anabrid/Model-1/software/examples/mathieu/README.md

mathieu.pl and its associated mathieu.yml perform a parameter variation in 
Mathieu's differential equation. For each parameter the y output is sampled
and finally displayed.
