anabrid/Model-1/(threads)

Thread 1 (2024-01-17):

MLT8 schematics are missing

metebalci, 2024-01-17:
MLT8 folder contains the schematics of MDS2.
