anabrid/Model-1/hardware/backplanes_etc/Backplane - Schematic.pdf

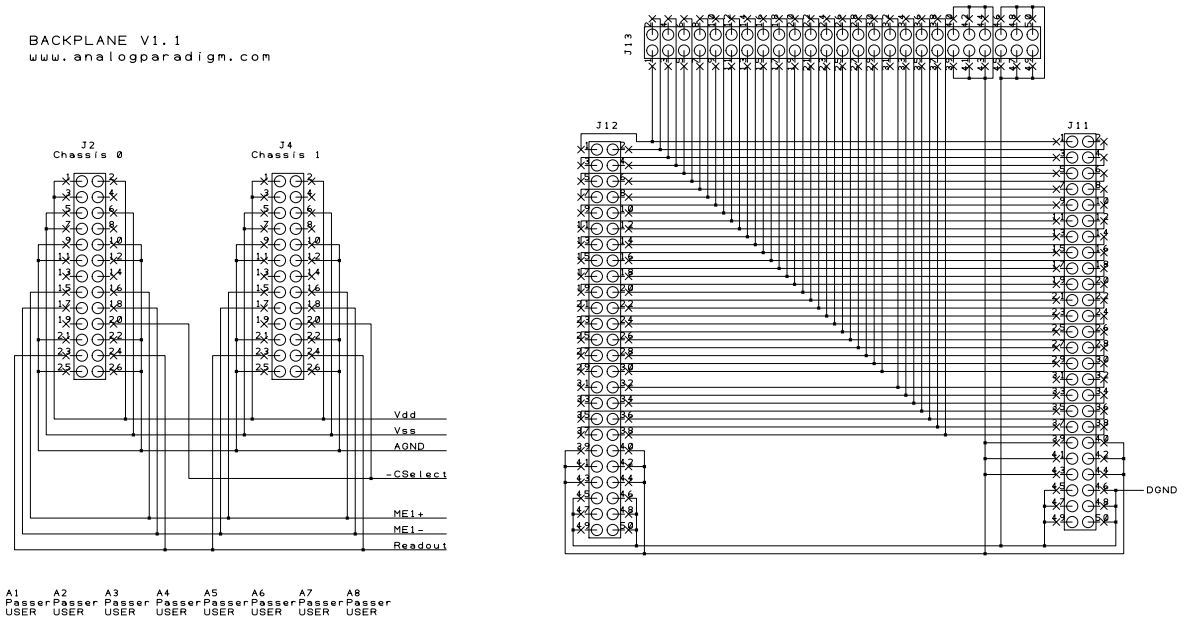
[picture p1: page 1]
