anabrid/Model-1/hardware/backplanes_etc/BackplaneMains - Schematic.pdf

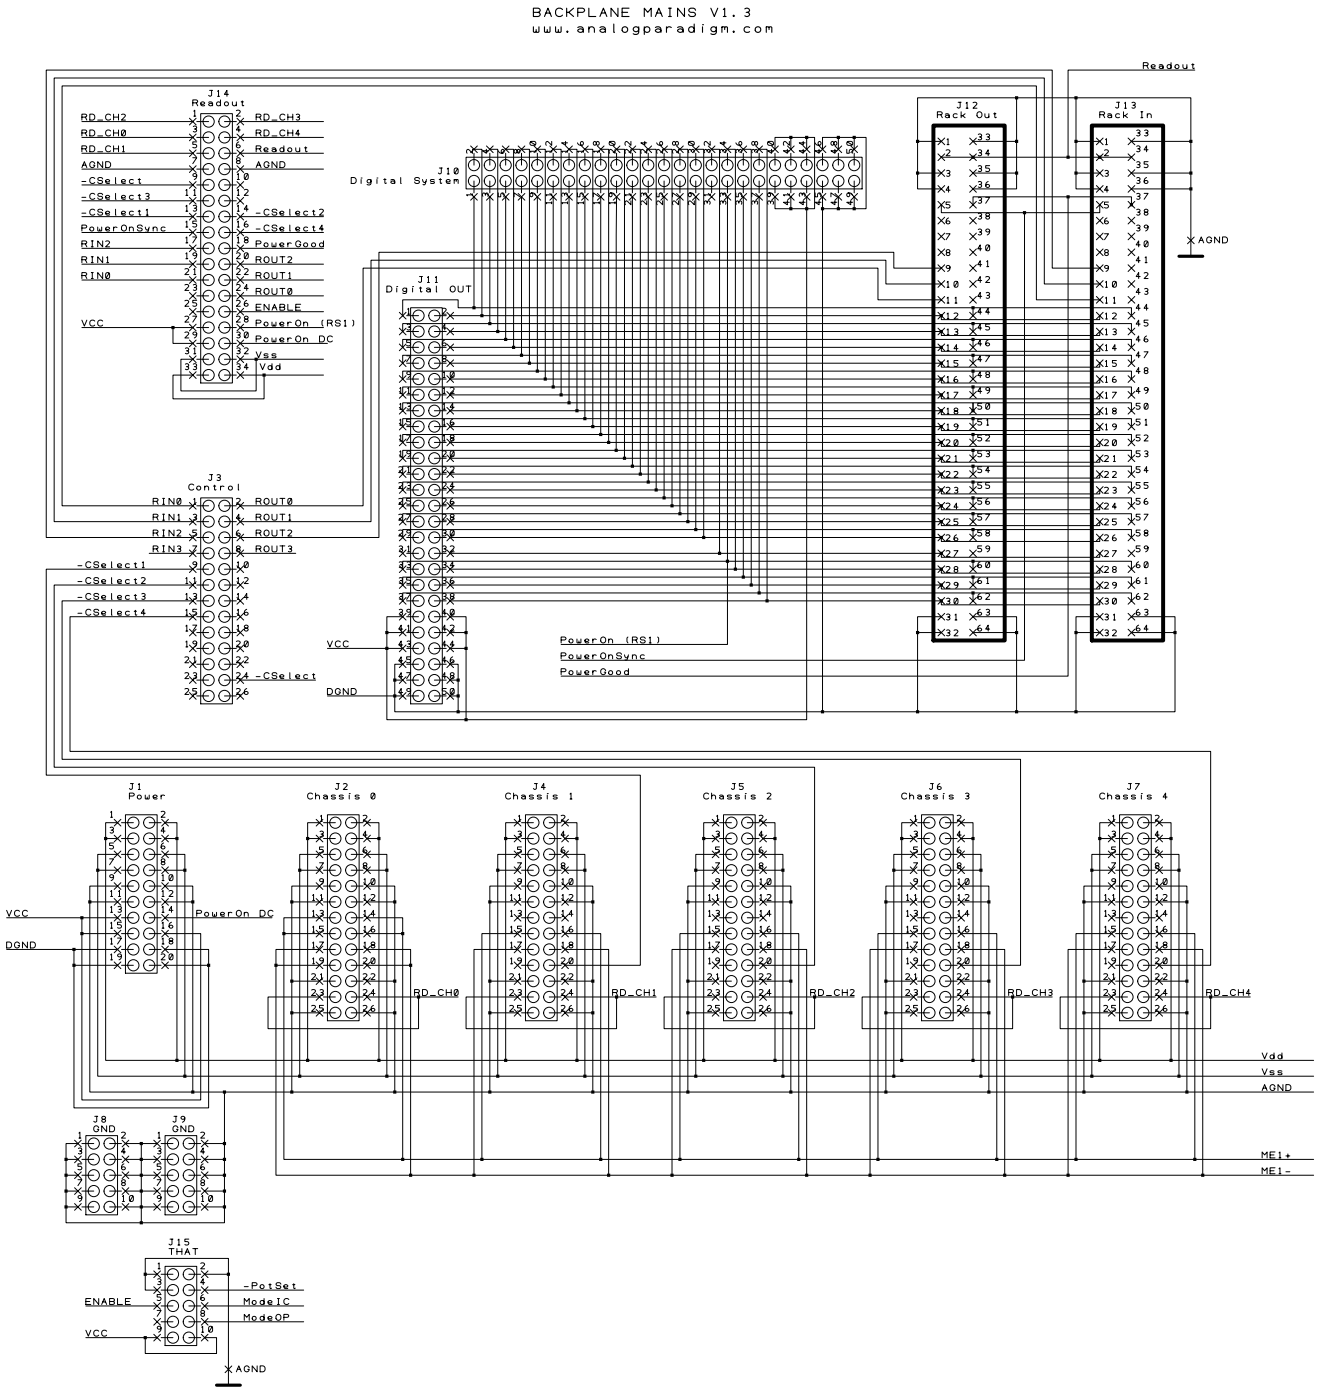
[picture p2: page 1]
