anabrid/Model-1/hardware/backplanes_etc/DCDC-Mains - Schematic.pdf

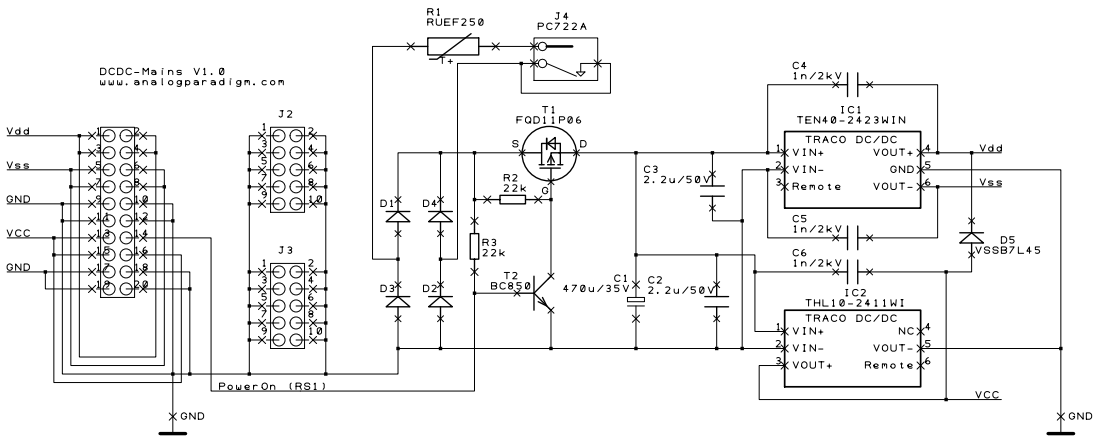
[picture p3: page 1]
