anabrid/Model-1/hardware/backplanes_etc/Readout-Mains - Schematic.pdf

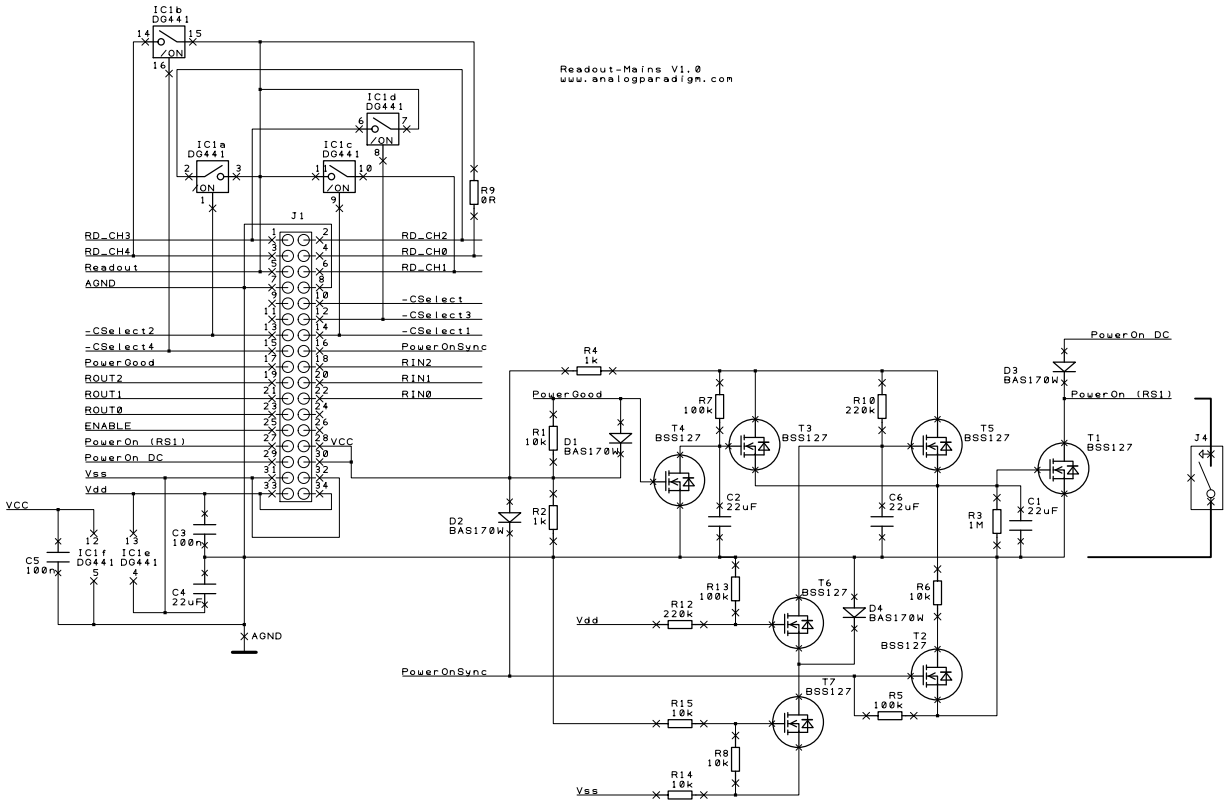
[picture p4: page 1]
