anabrid/Model-1/hardware/backplanes_etc/SYSBUS - Schematic.pdf

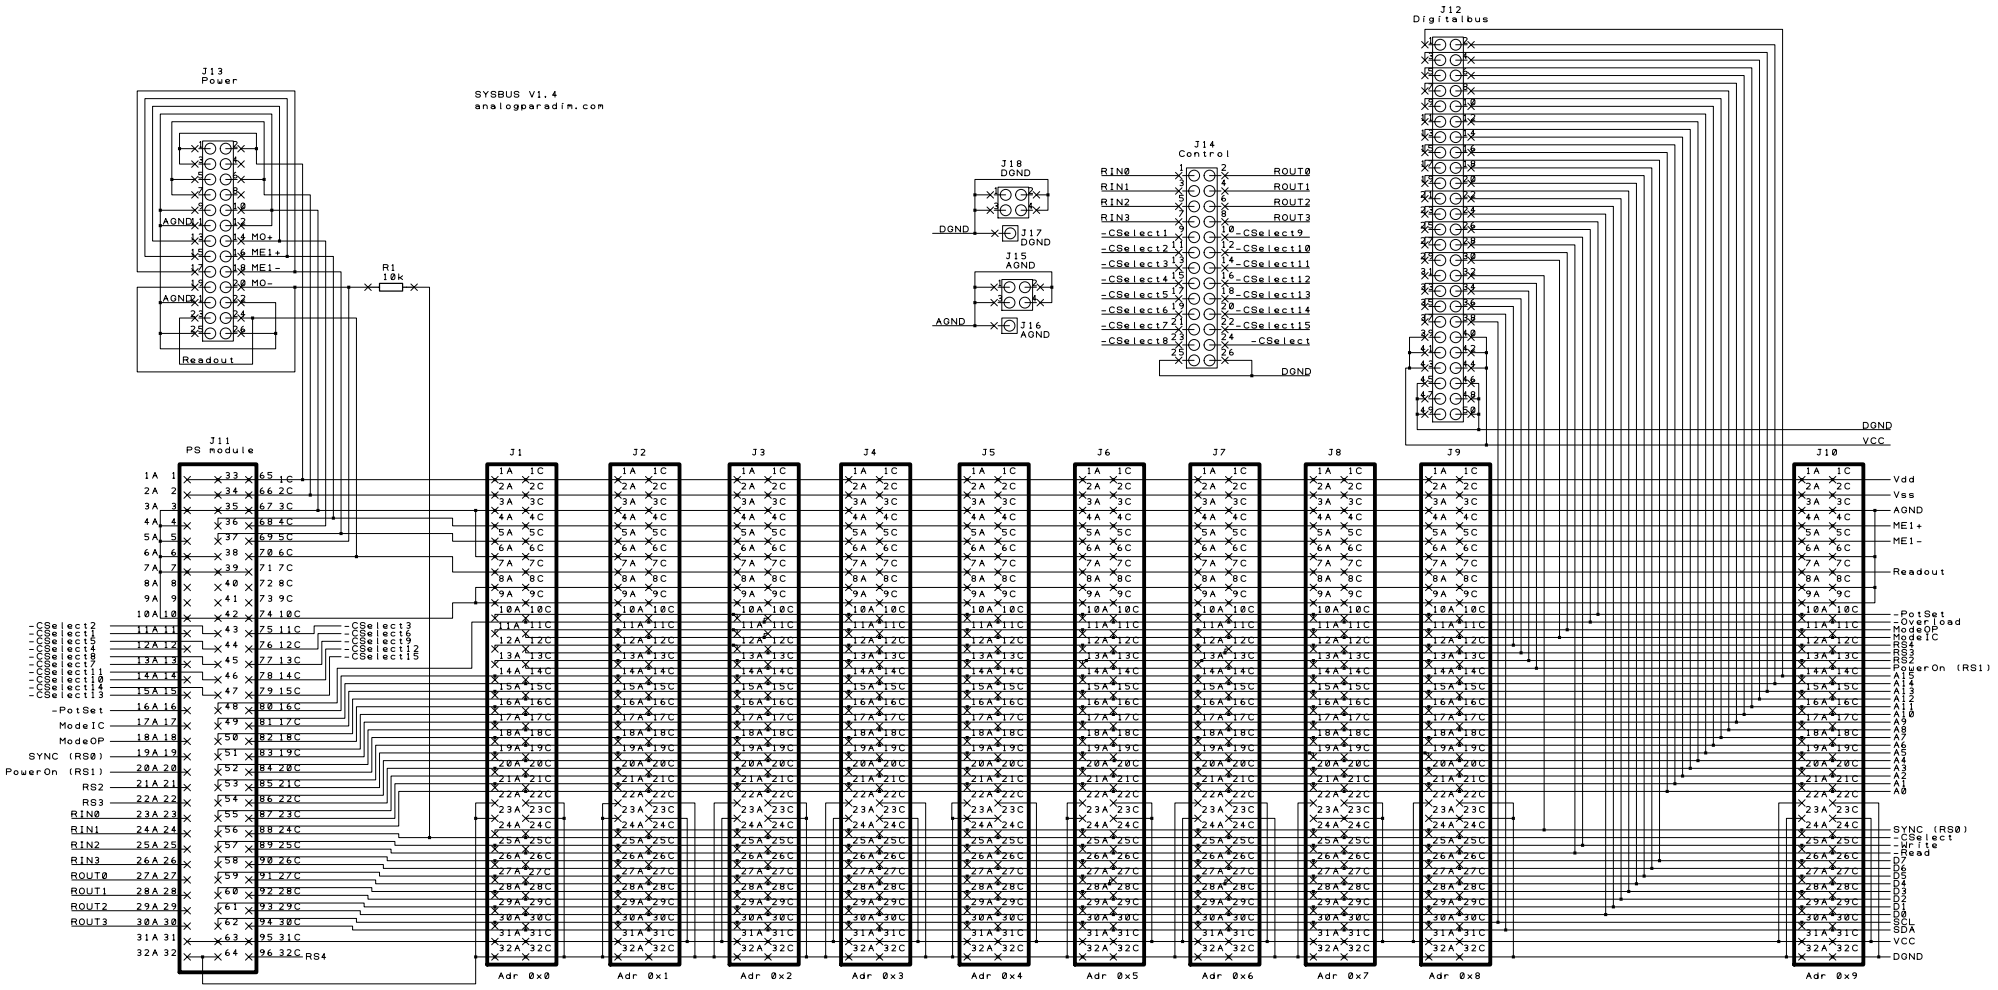
[picture p5: page 1]
