anabrid/Model-1/hardware/backplanes_etc/SYSBUS_Term - Schematic.pdf

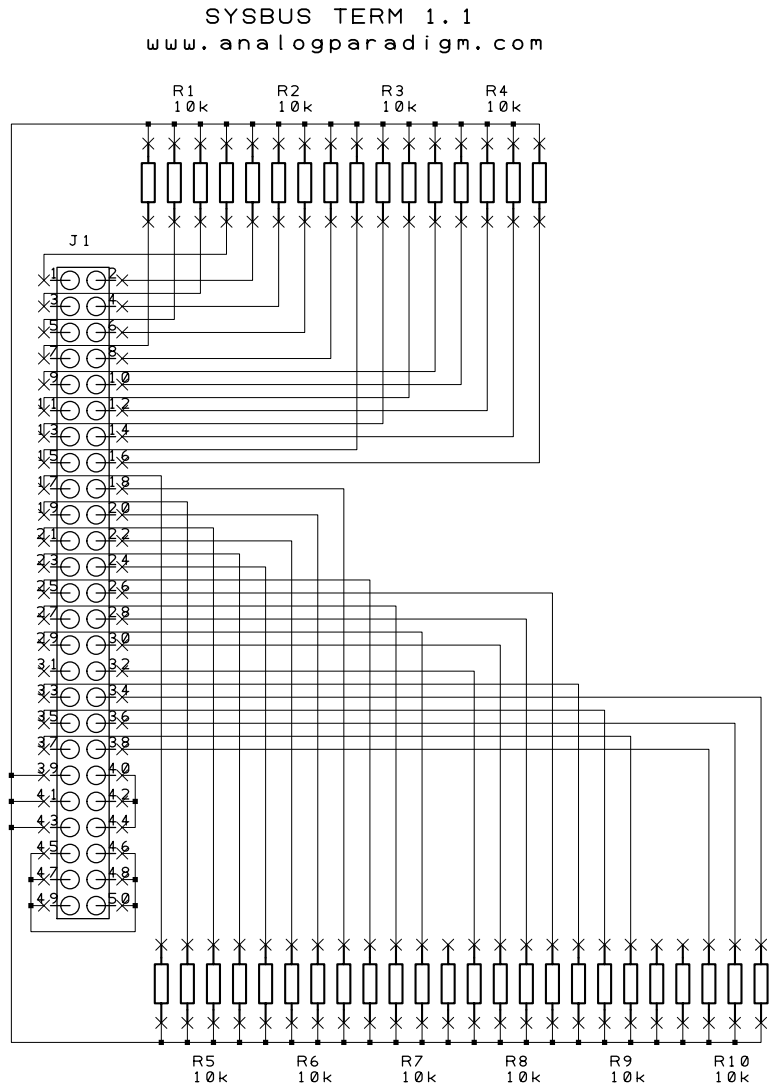
[picture p6: page 1]
