anabrid/Model-1/hardware/CMP4/CMP4 - Schematic.pdf

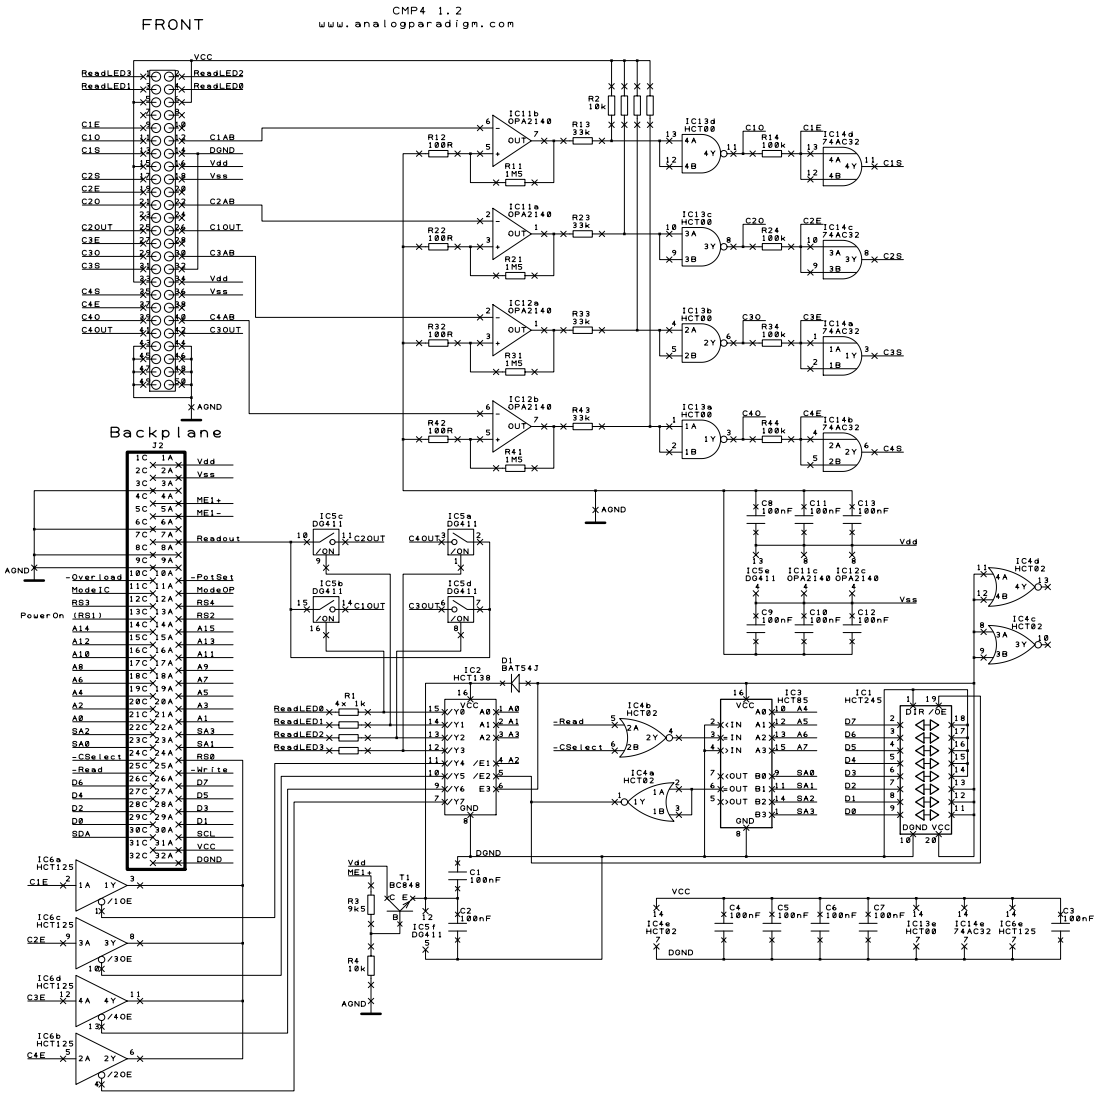
[picture p7: page 1]
