anabrid/Model-1/hardware/CMP4/CMP4-Front - Schematic.pdf

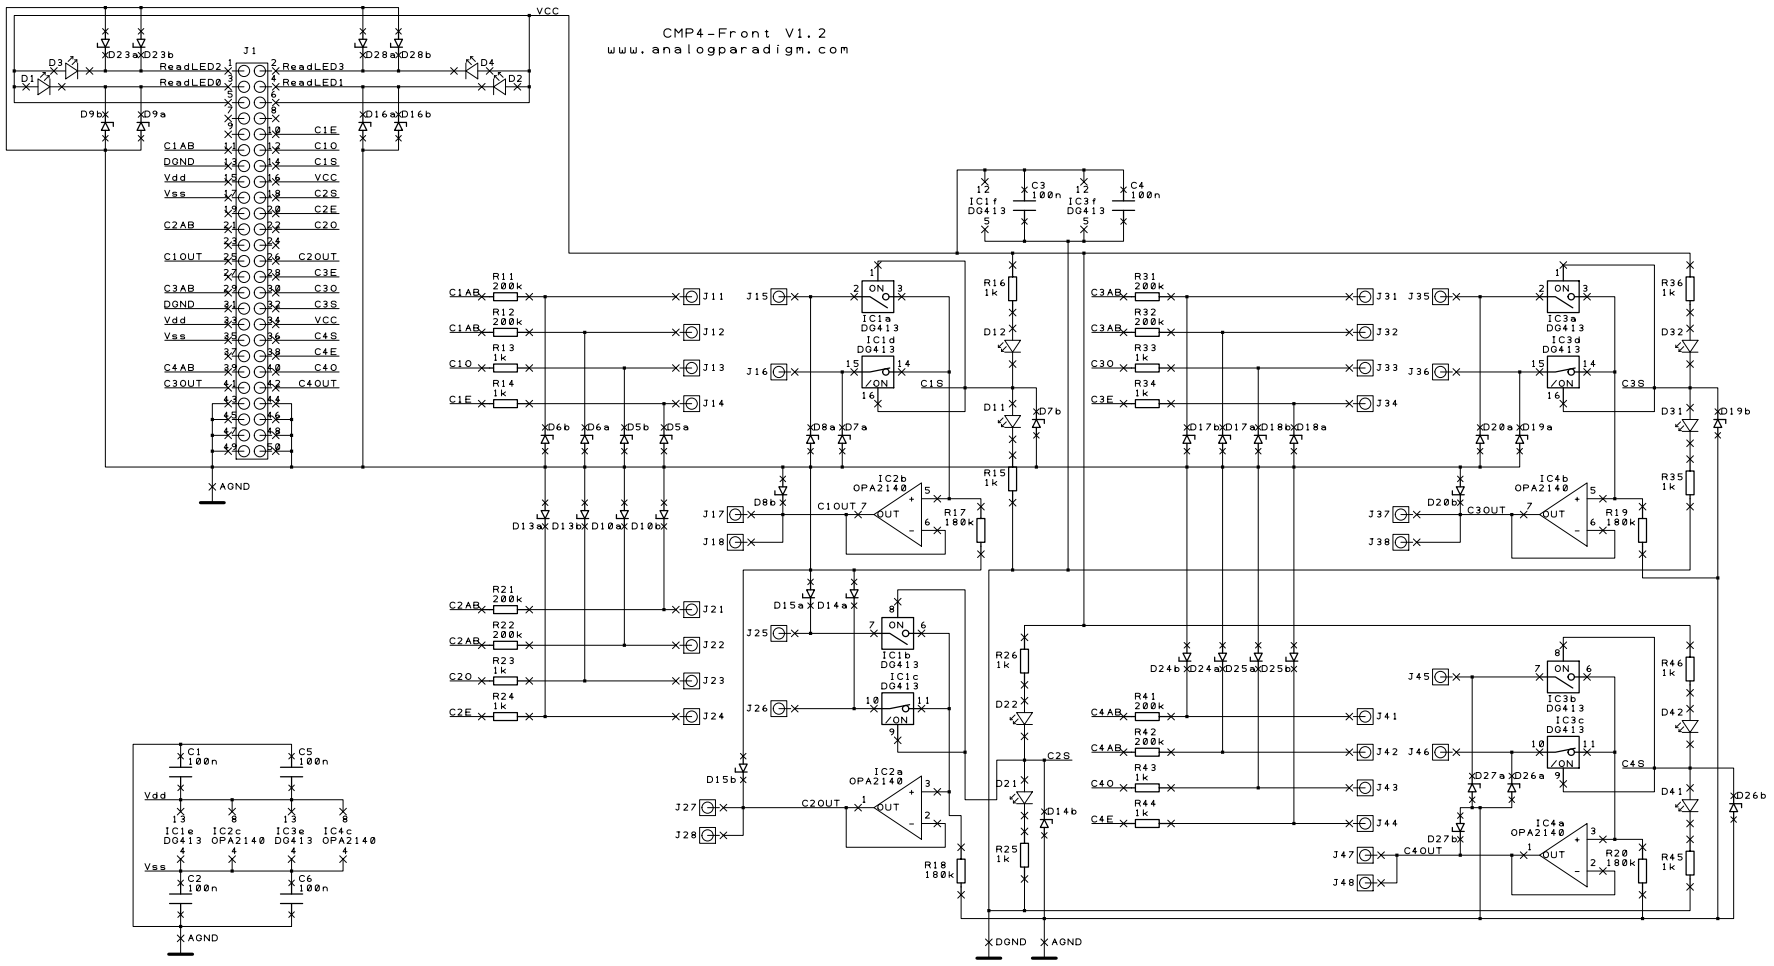
[picture p8: page 1]
