anabrid/Model-1/hardware/CU/CU - Schematic.pdf

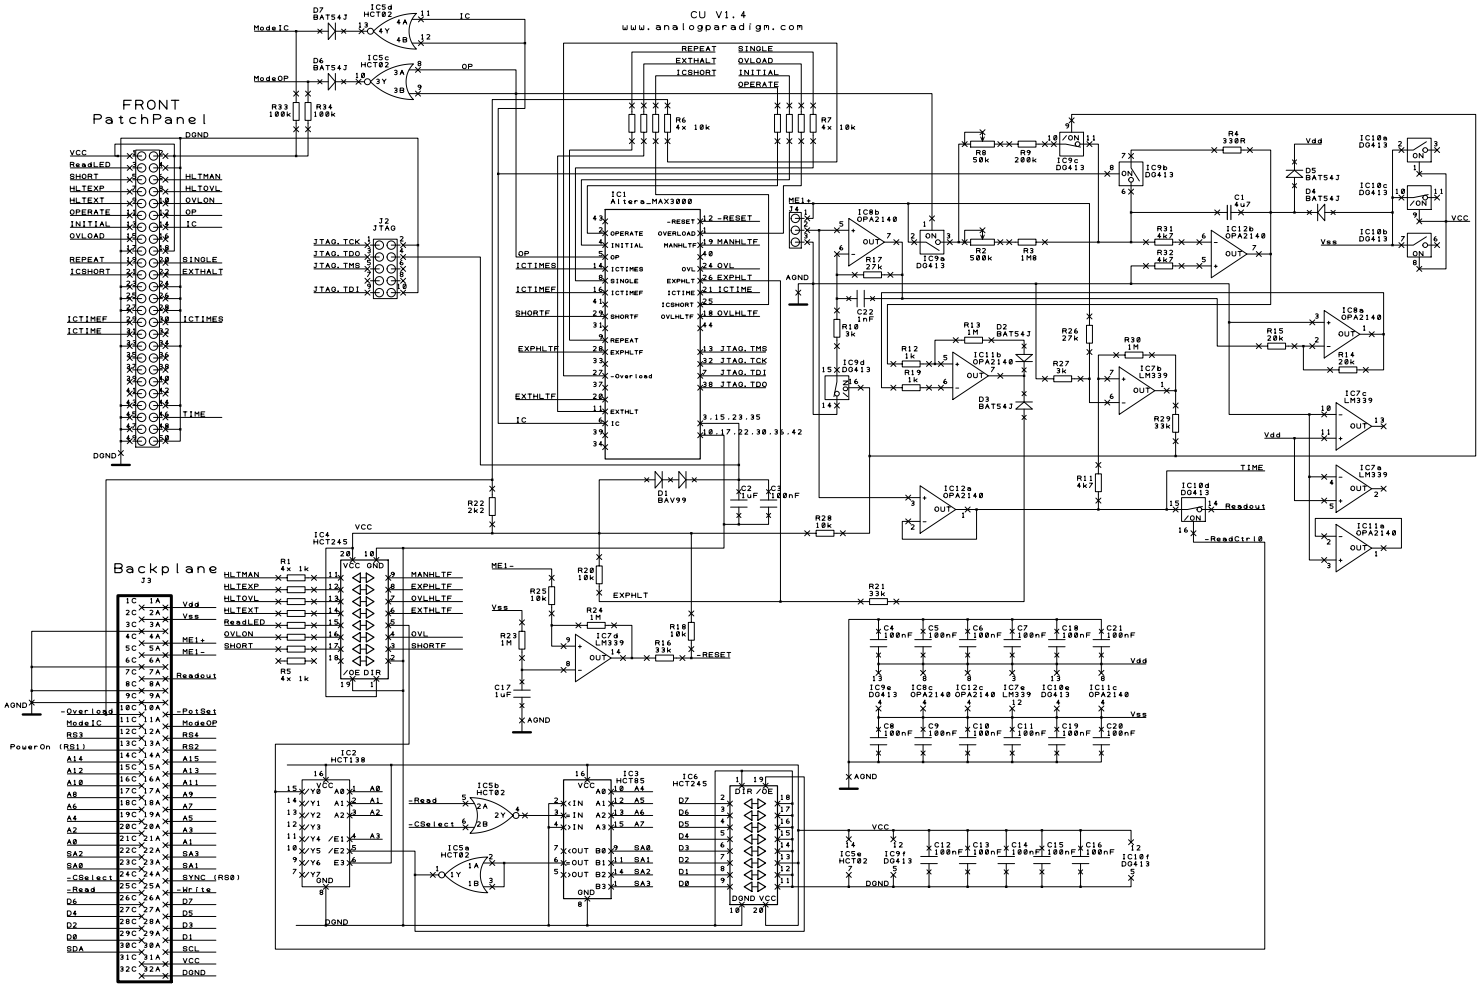
[picture p9: page 1]
