anabrid/Model-1/hardware/CU/CU-Front - Schematic.pdf

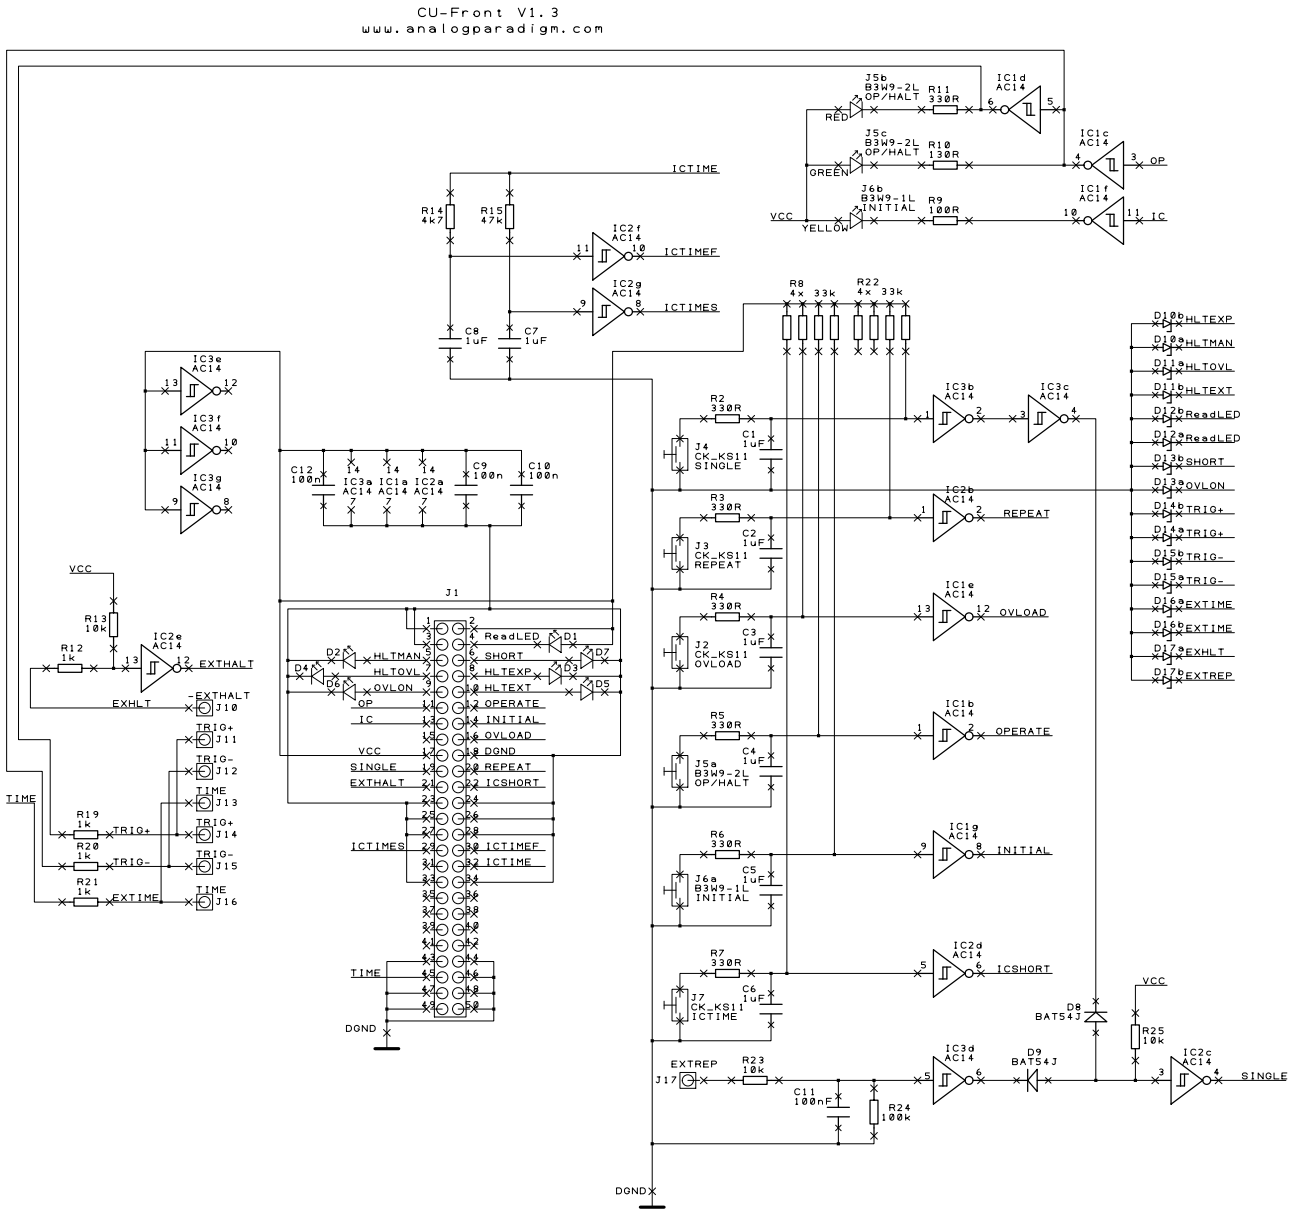
[picture p10: page 1]
