anabrid/Model-1/hardware/DPT24/DPT24 - Schematic.pdf

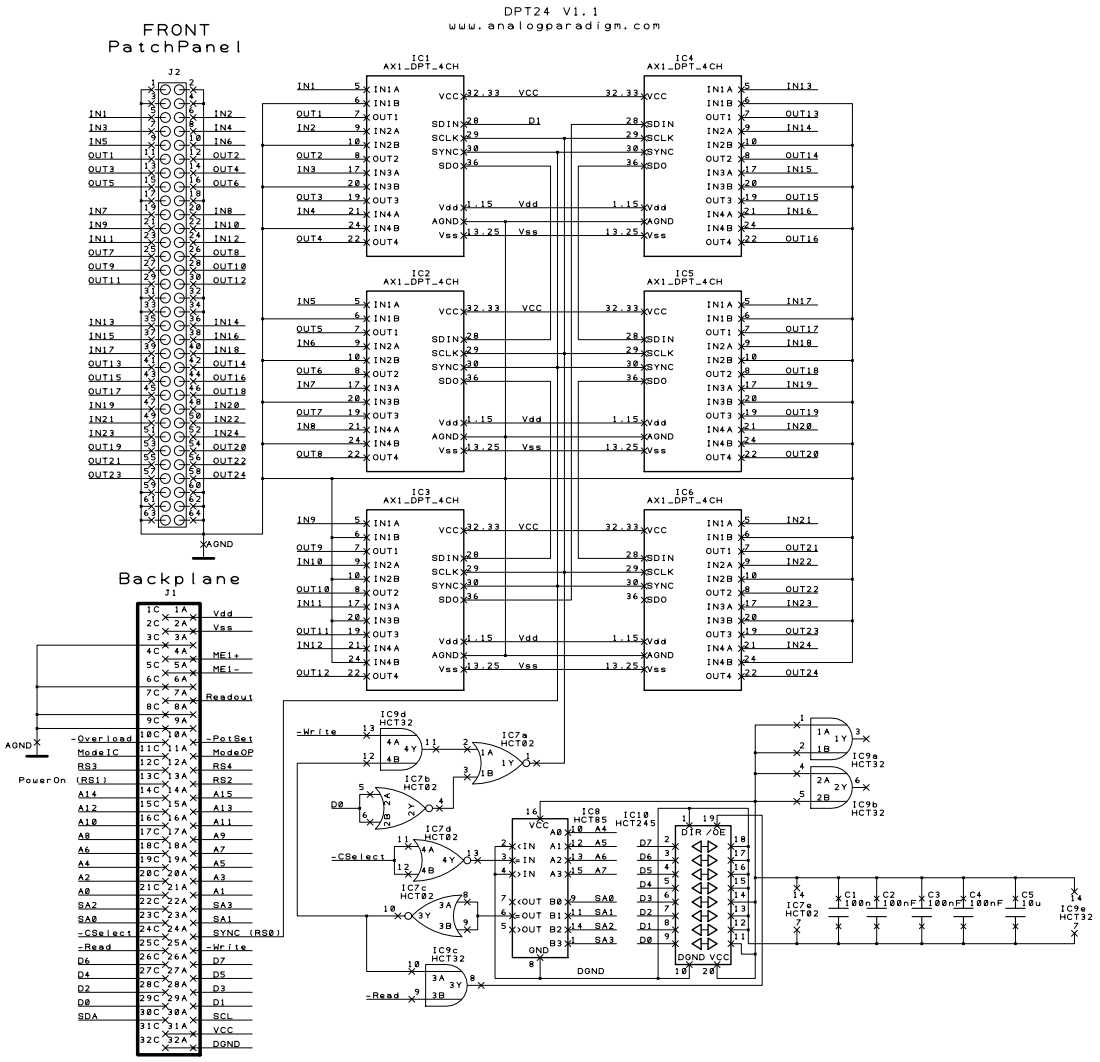
[picture p11: page 1]
