anabrid/Model-1/hardware/DPT24/DPT24-FRONT - Schematic.pdf

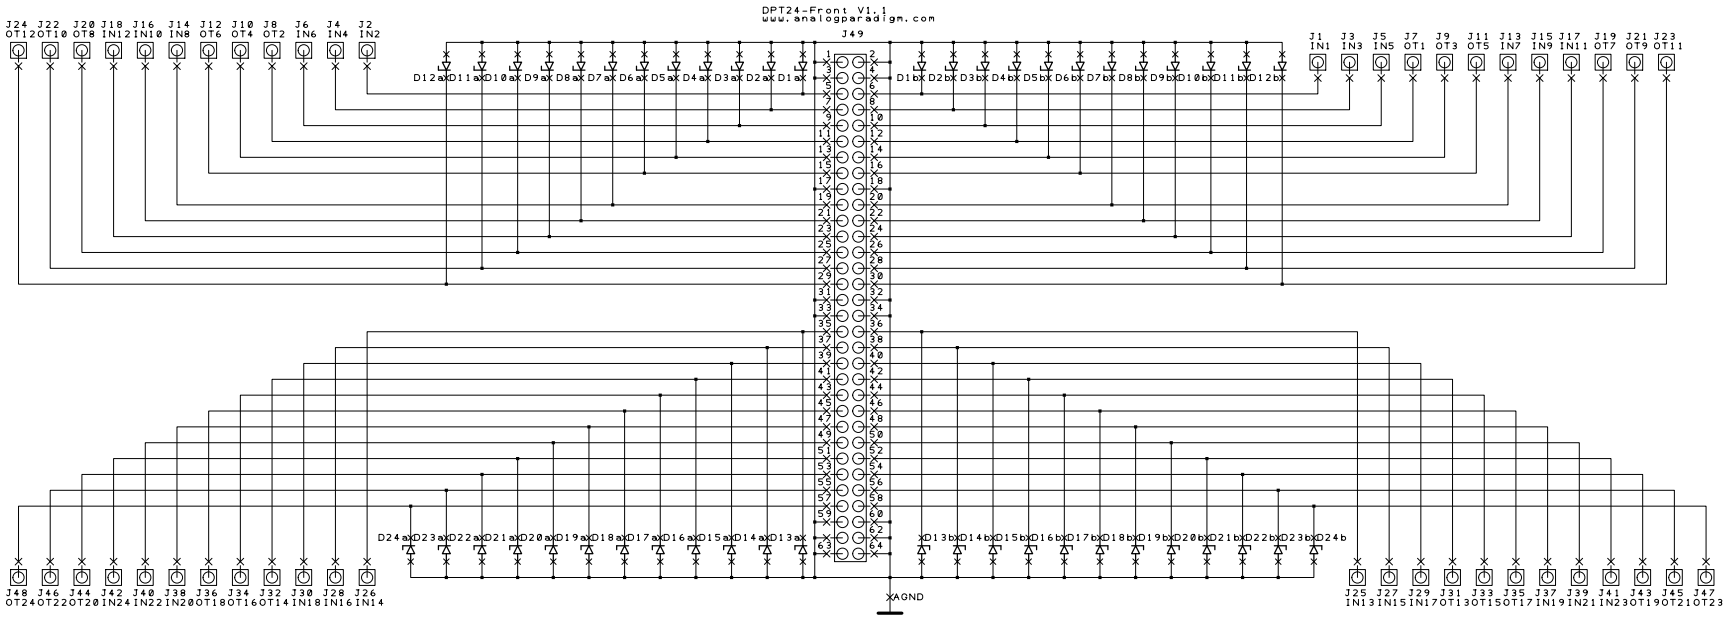
[picture p12: page 1]
