anabrid/Model-1/hardware/DPT24/DPT_4Ch - Schematic.pdf

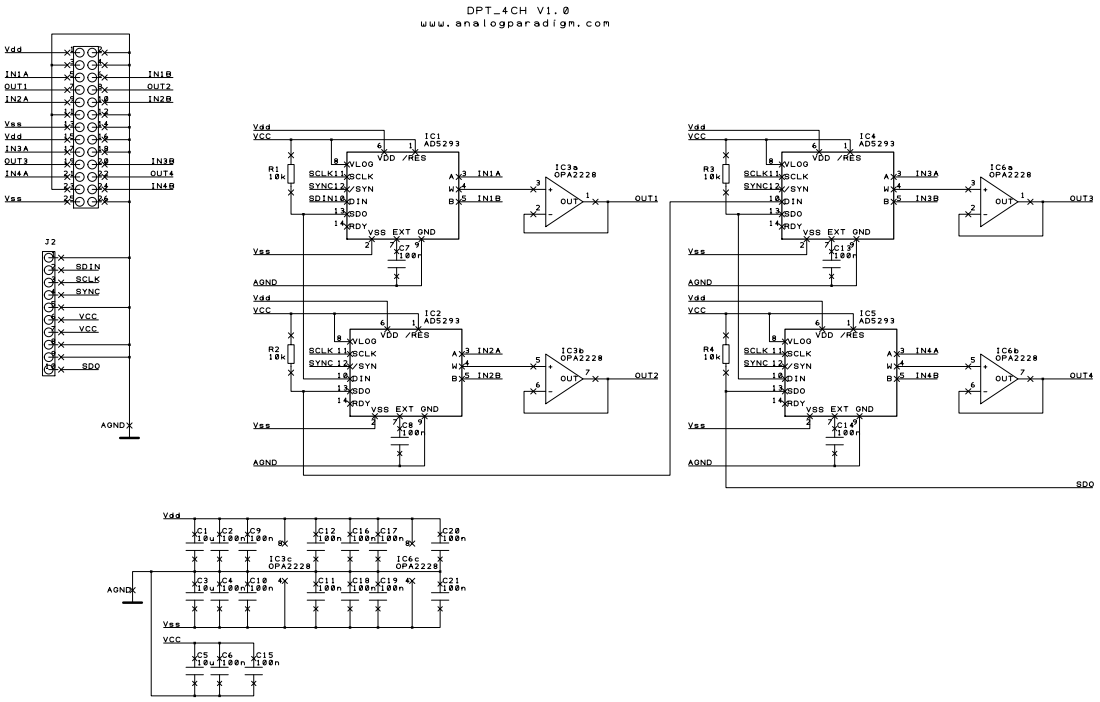
[picture p13: page 1]
