anabrid/Model-1/hardware/HC/HC - Schematic.pdf

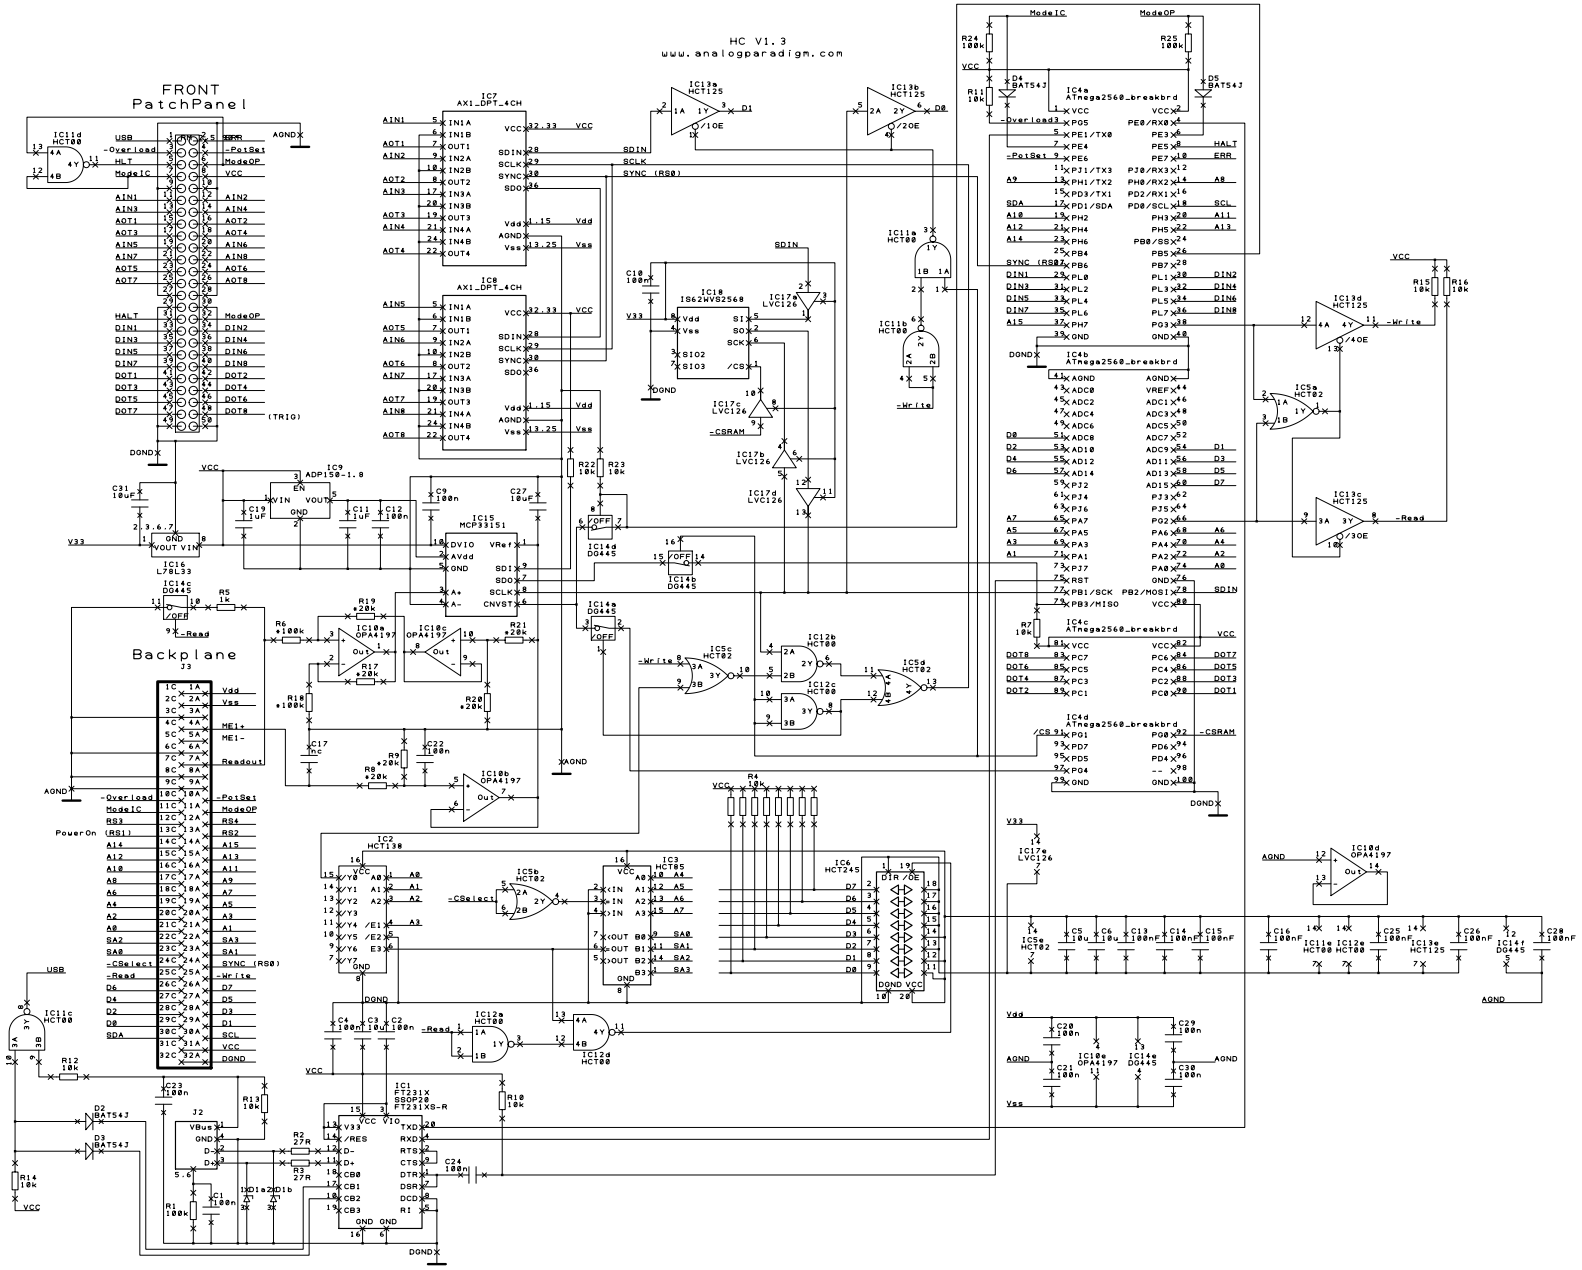
[picture p14: page 1]
