anabrid/Model-1/hardware/HC/HC-Front - Schematic.pdf

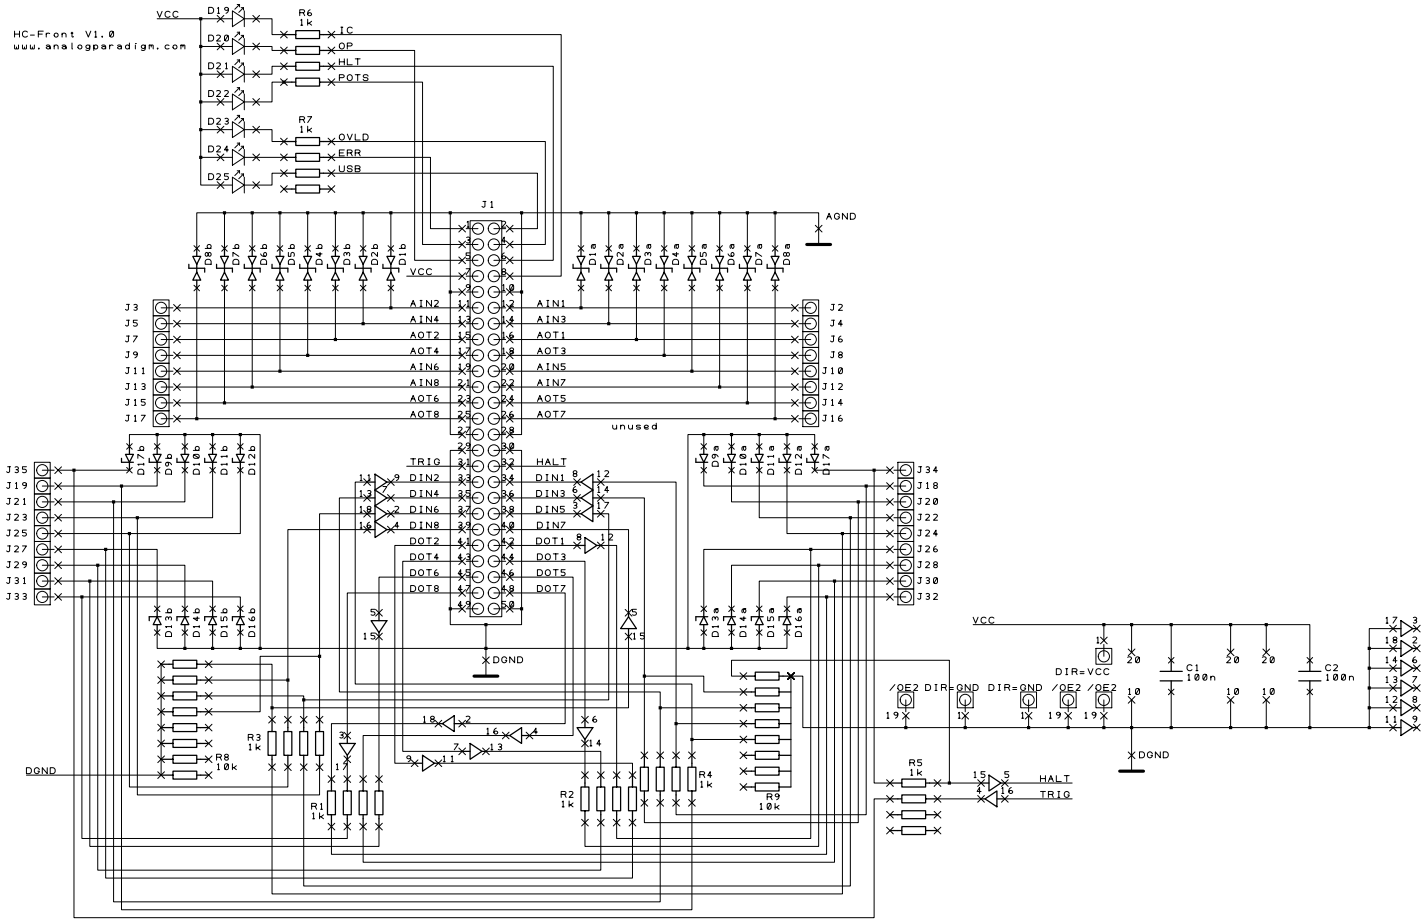
[picture p15: page 1]
