anabrid/Model-1/hardware/INT4/INT4 - Schematic.pdf

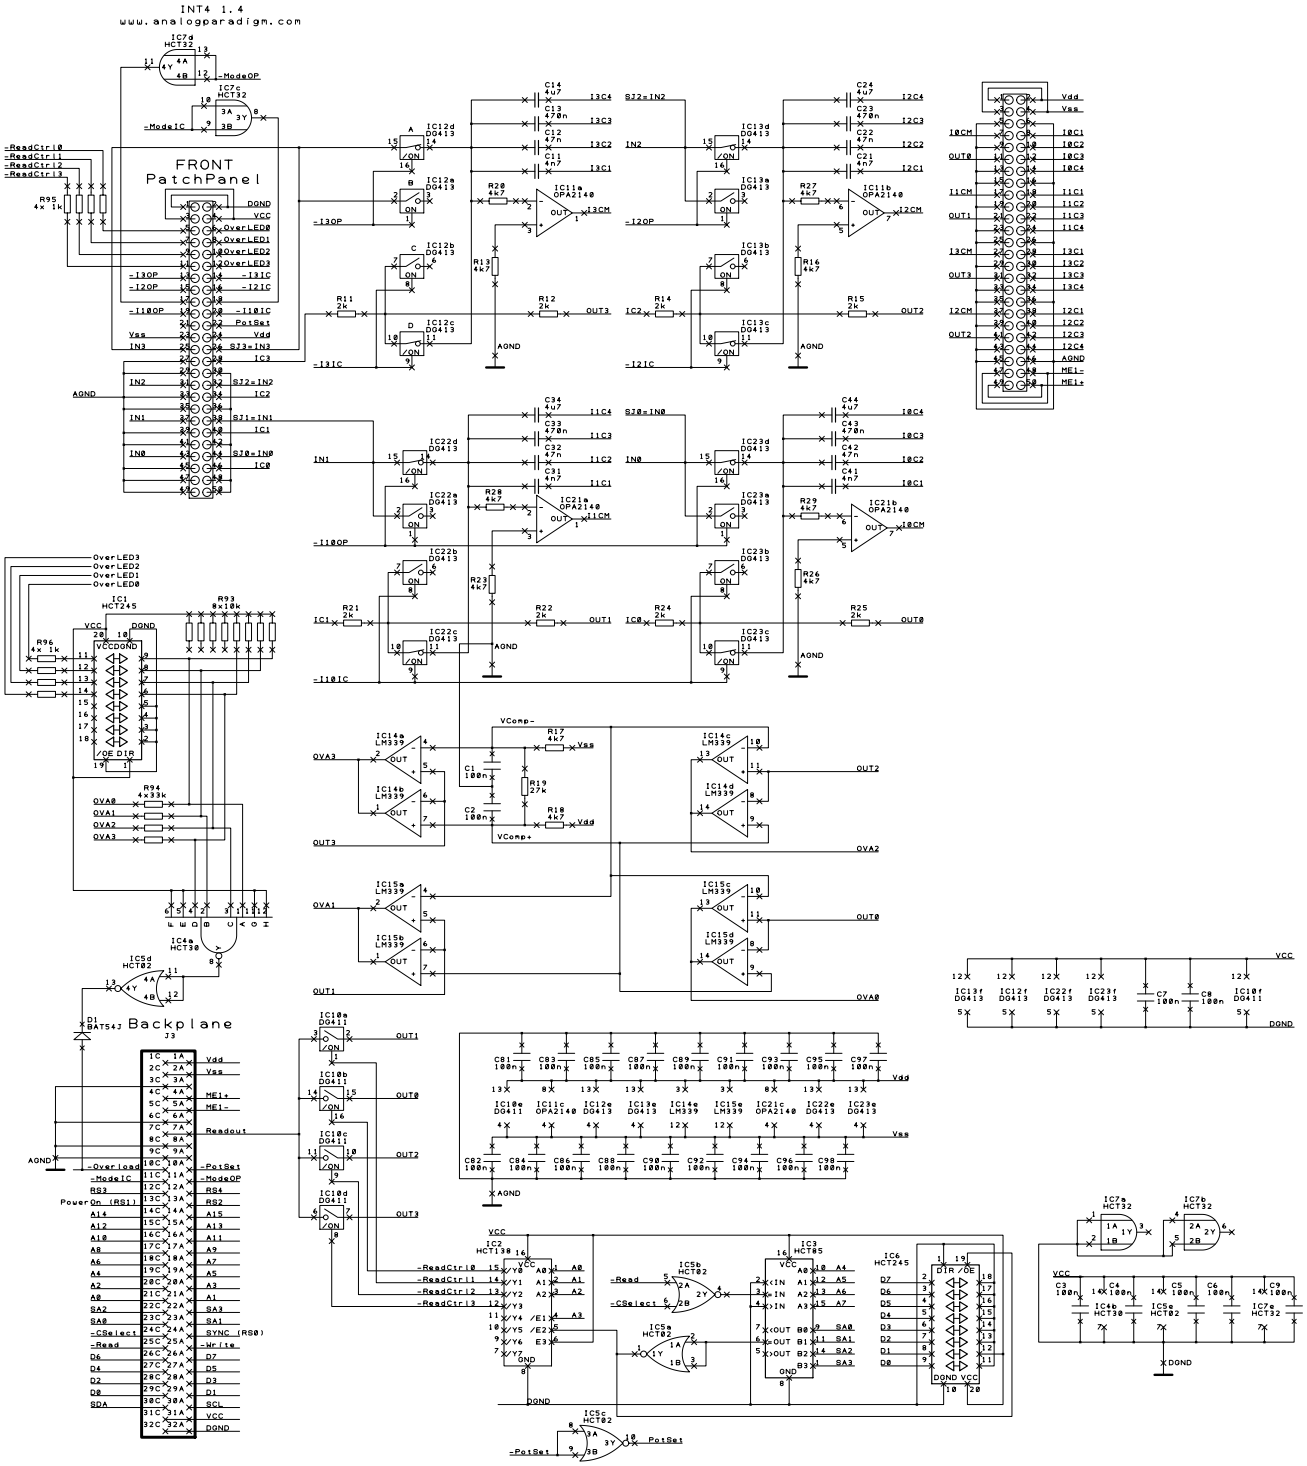
[picture p16: page 1]
