anabrid/Model-1/hardware/INT4/INT4-Front - Schematic.pdf

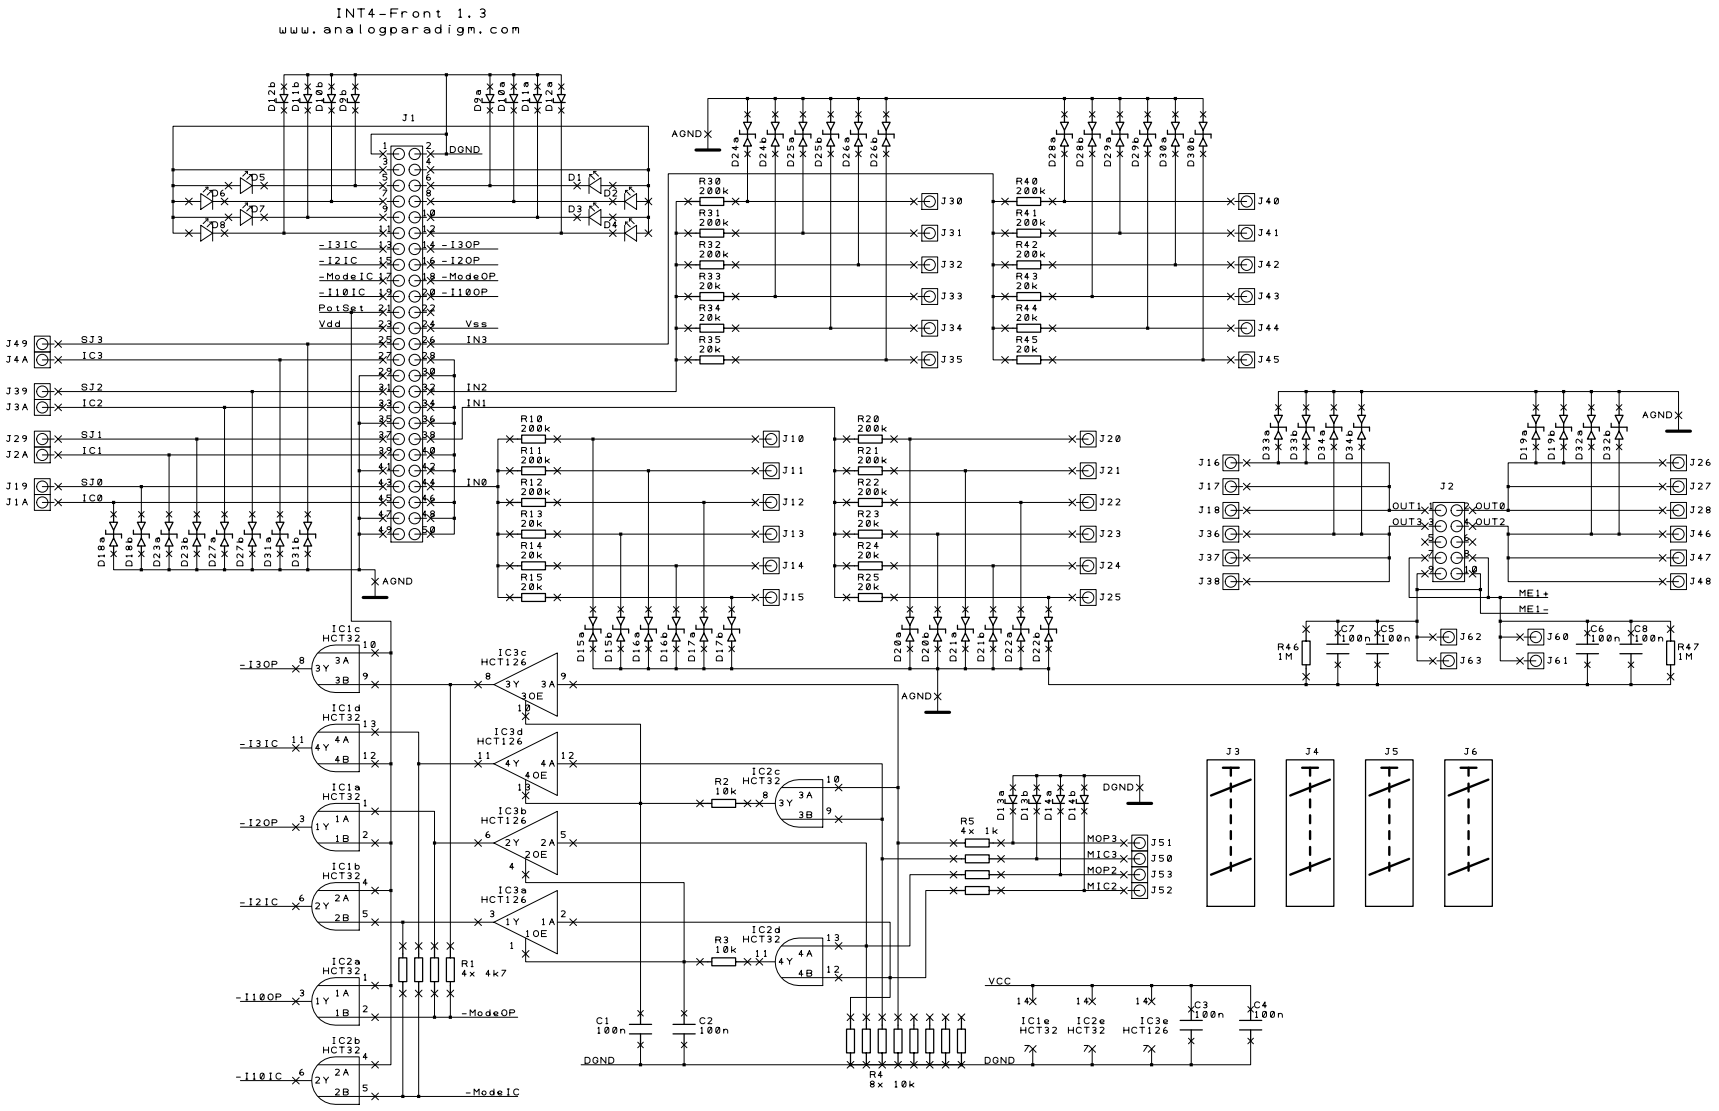
[picture p17: page 1]
