anabrid/Model-1/hardware/INT4/INT4-Switch - Schematic.pdf

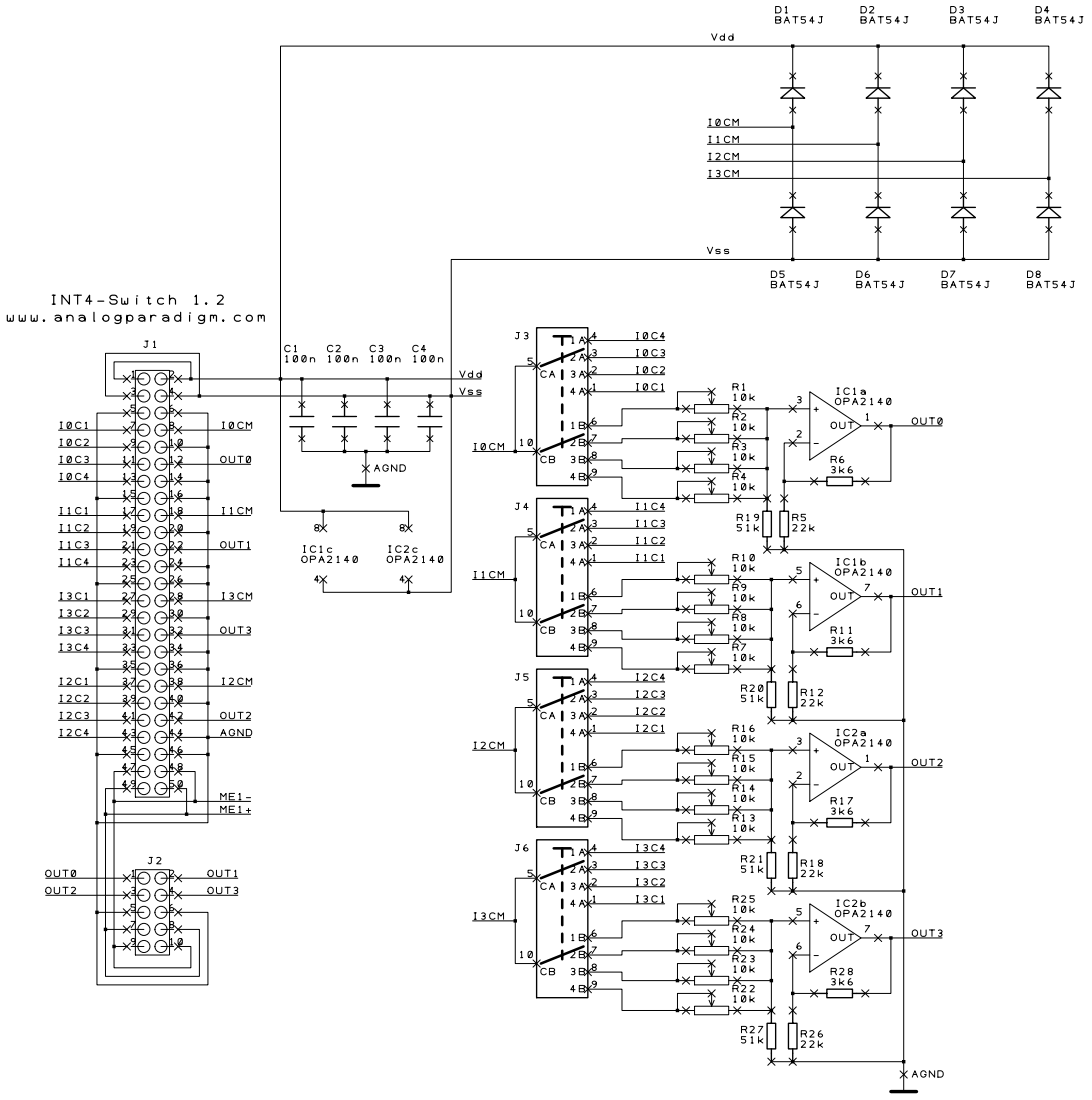
[picture p18: page 1]
