anabrid/Model-1/hardware/MDS2/MDS2 - Schematic.pdf

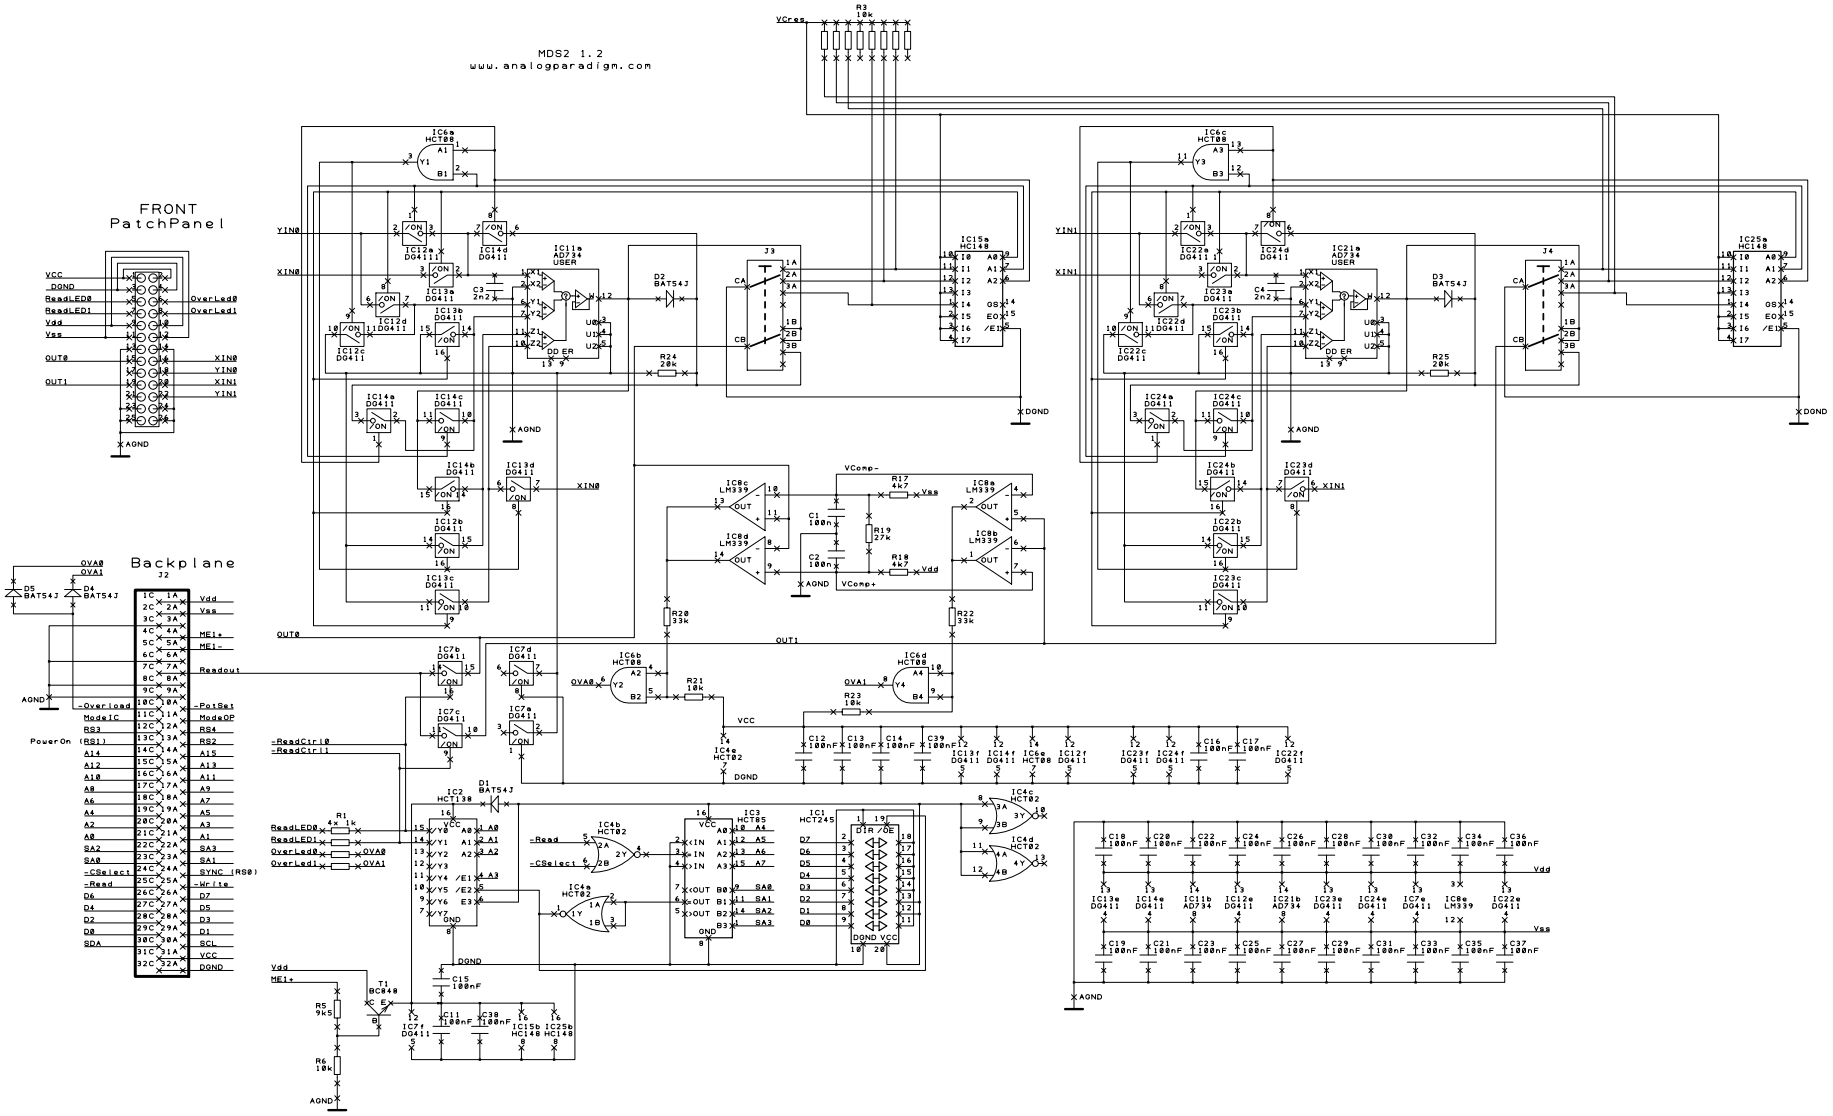
[picture p19: page 1]
