anabrid/Model-1/hardware/MDS2/MDS2-Front - Schematic.pdf

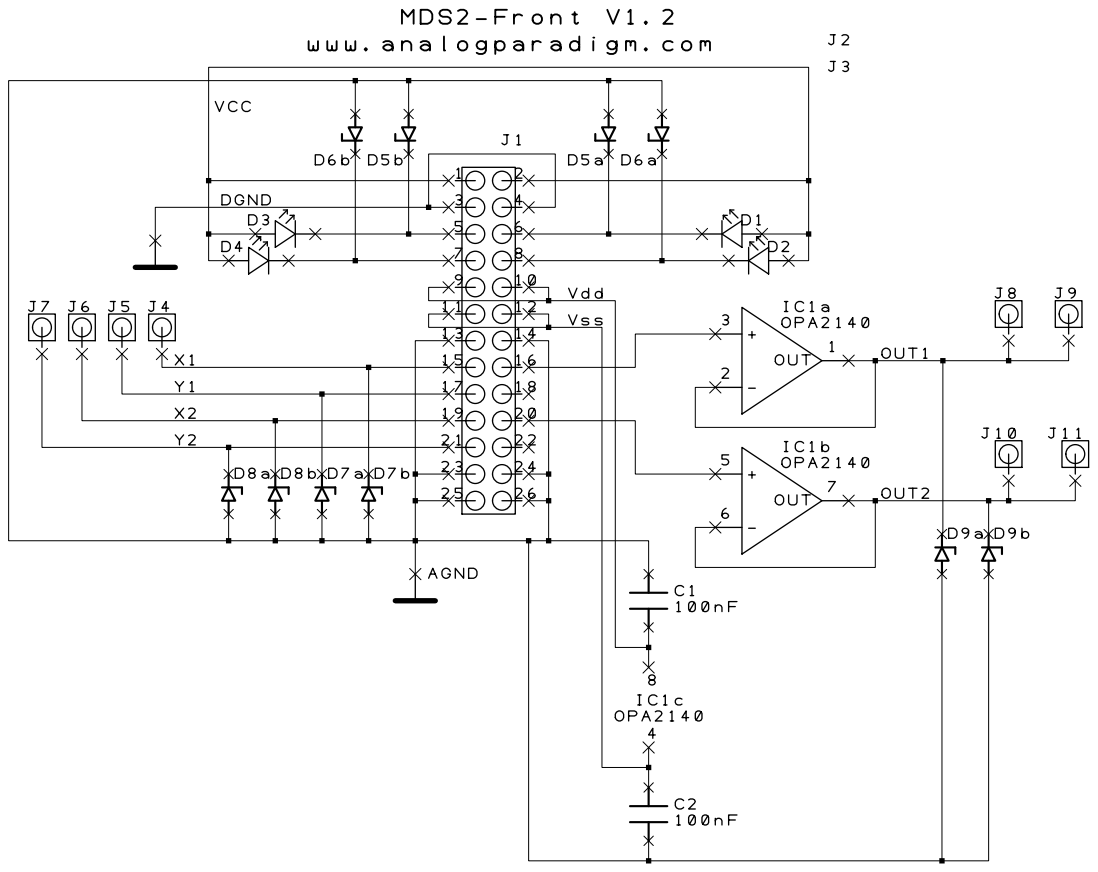
[picture p20: page 1]
