anabrid/Model-1/hardware/PS/PS - Schematic.pdf

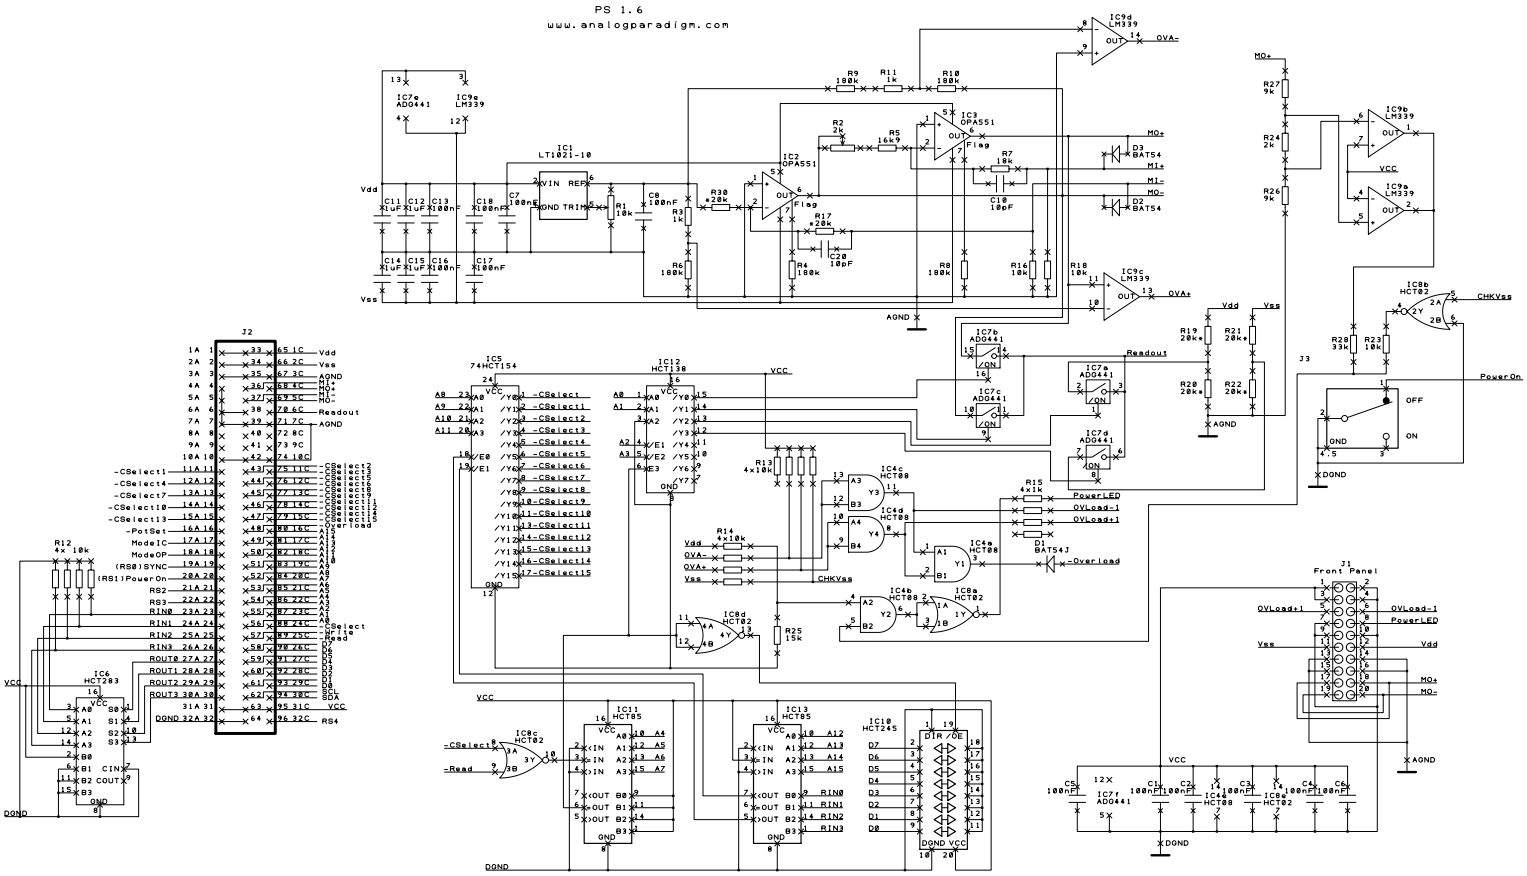
[picture p21: page 1]
