anabrid/Model-1/hardware/PS/PS-FRONT - Schematic.pdf

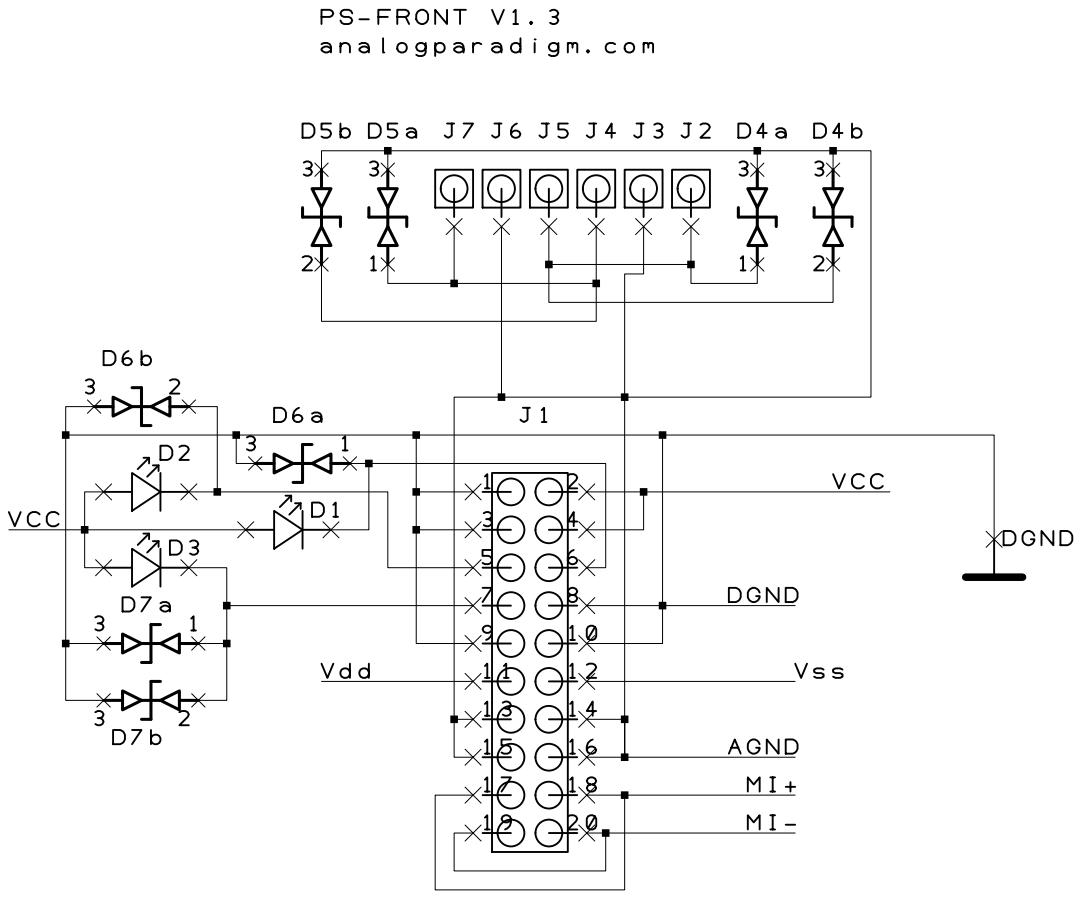
[picture p22: page 1]
