anabrid/Model-1/hardware/PT8/PT8 - Schematic.pdf

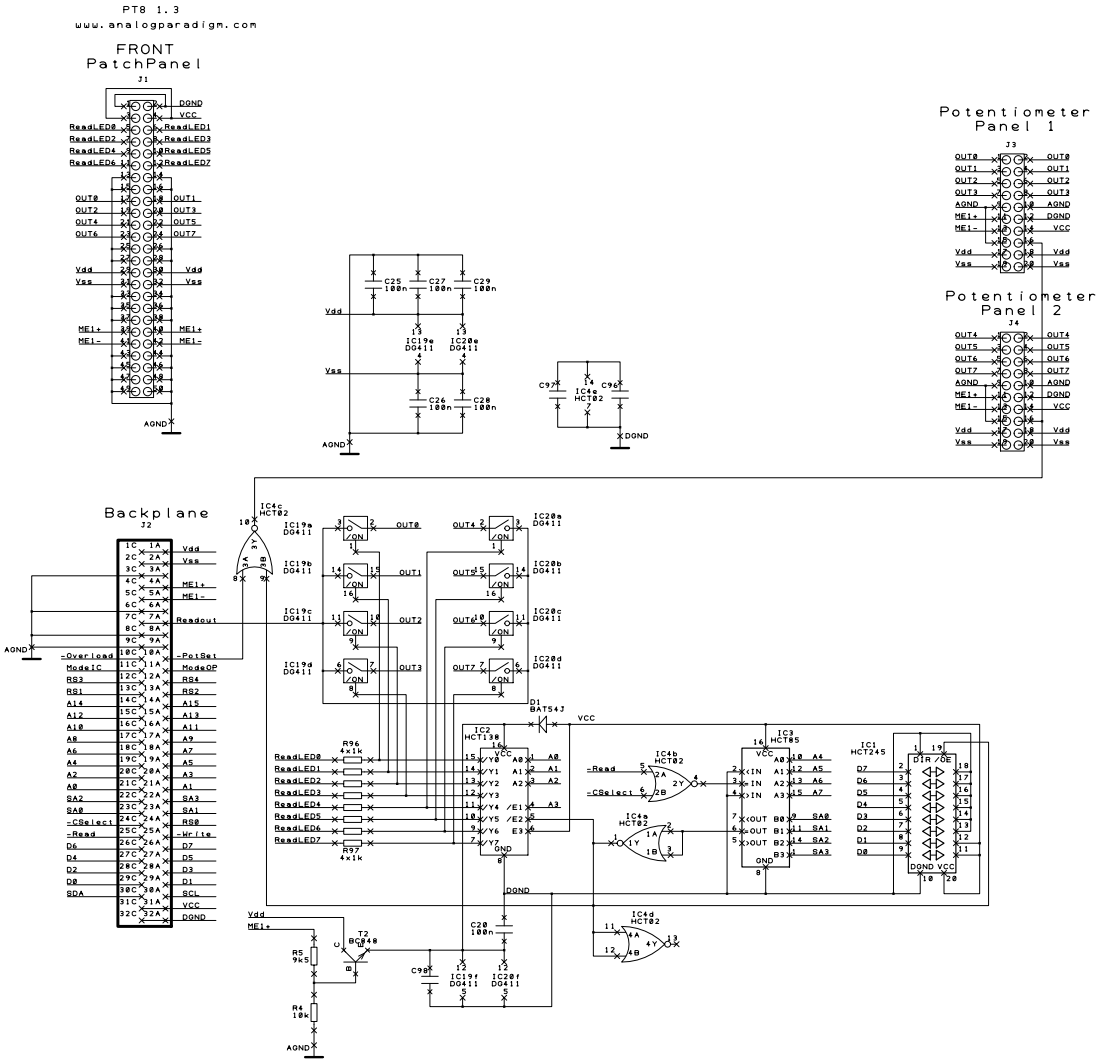
[picture p23: page 1]
