anabrid/Model-1/hardware/PT8/PT8-Front - Schematic.pdf

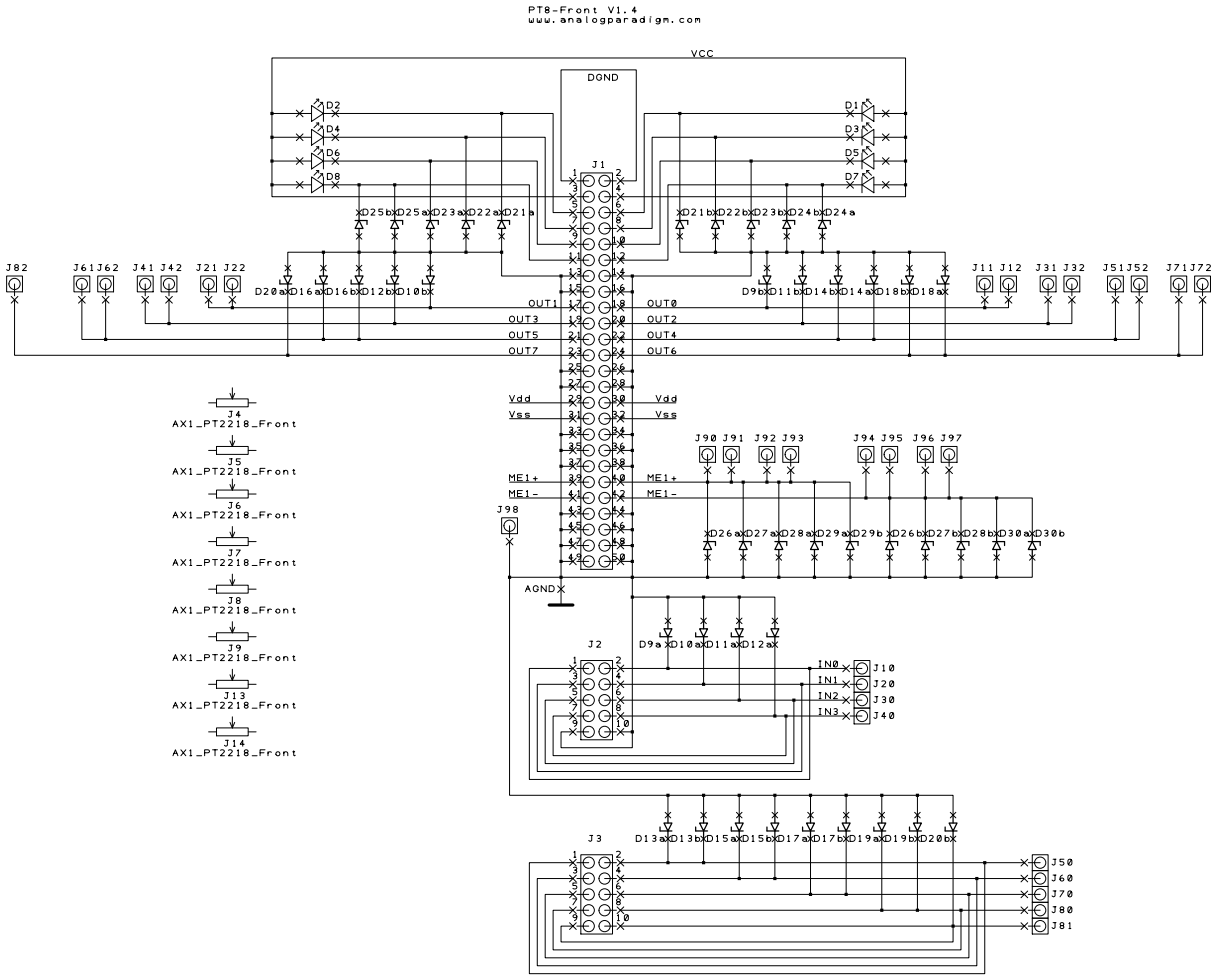
[picture p24: page 1]
