anabrid/Model-1/hardware/PT8/PT8-Pots - Schematic.pdf

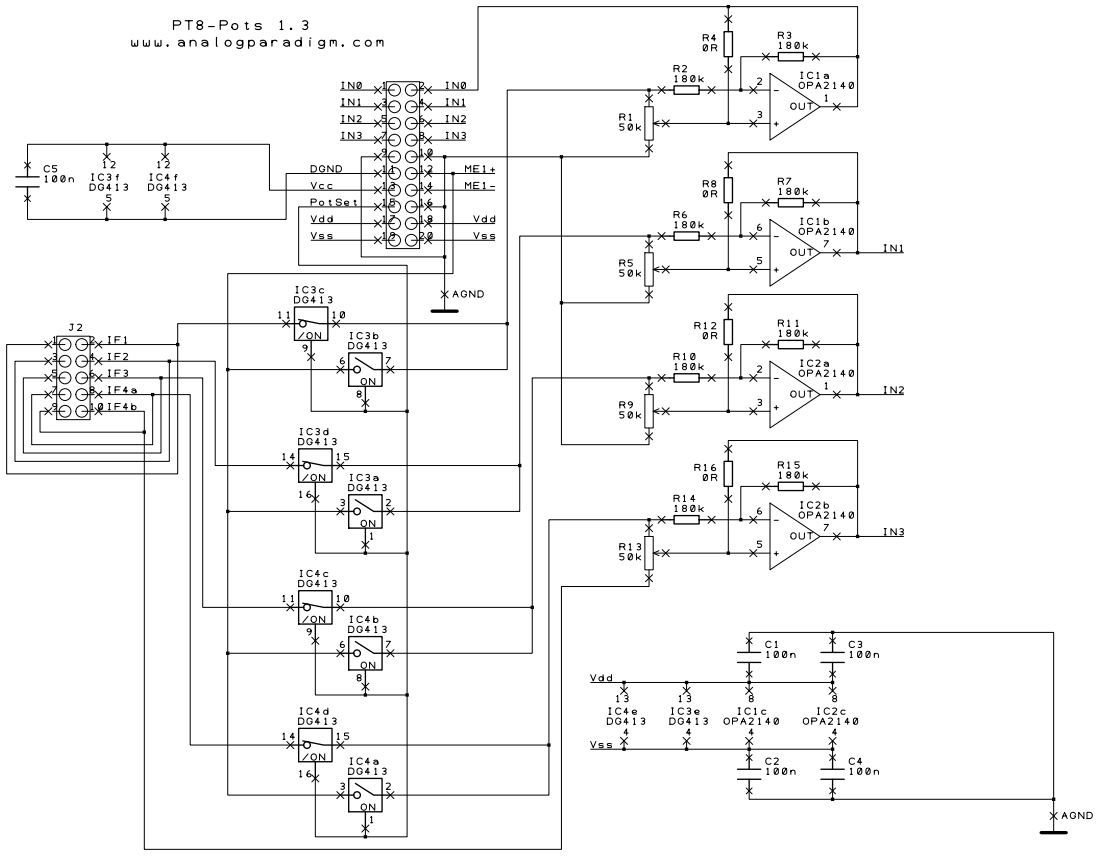
[picture p25: page 1]
