anabrid/Model-1/hardware/SUM8/SUM8 - Schematic.pdf

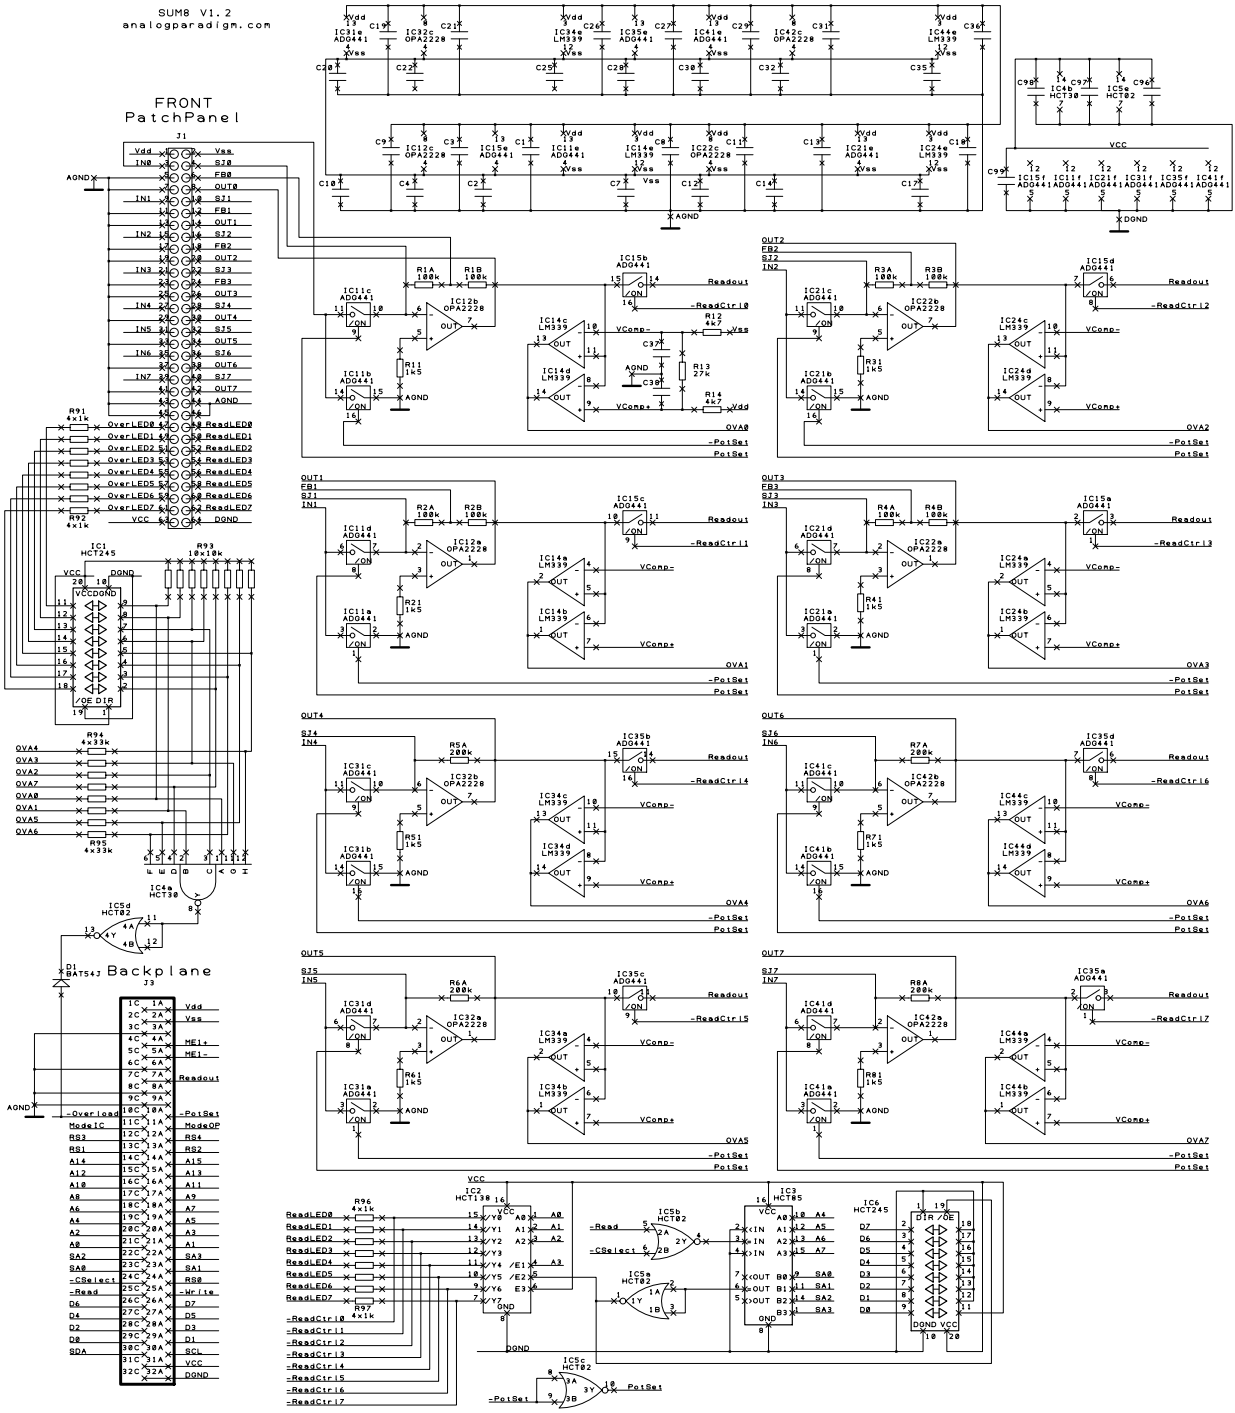
[picture p26: page 1]
