anabrid/Model-1/hardware/SUM8/SUM8-FRONT - Schematic.pdf

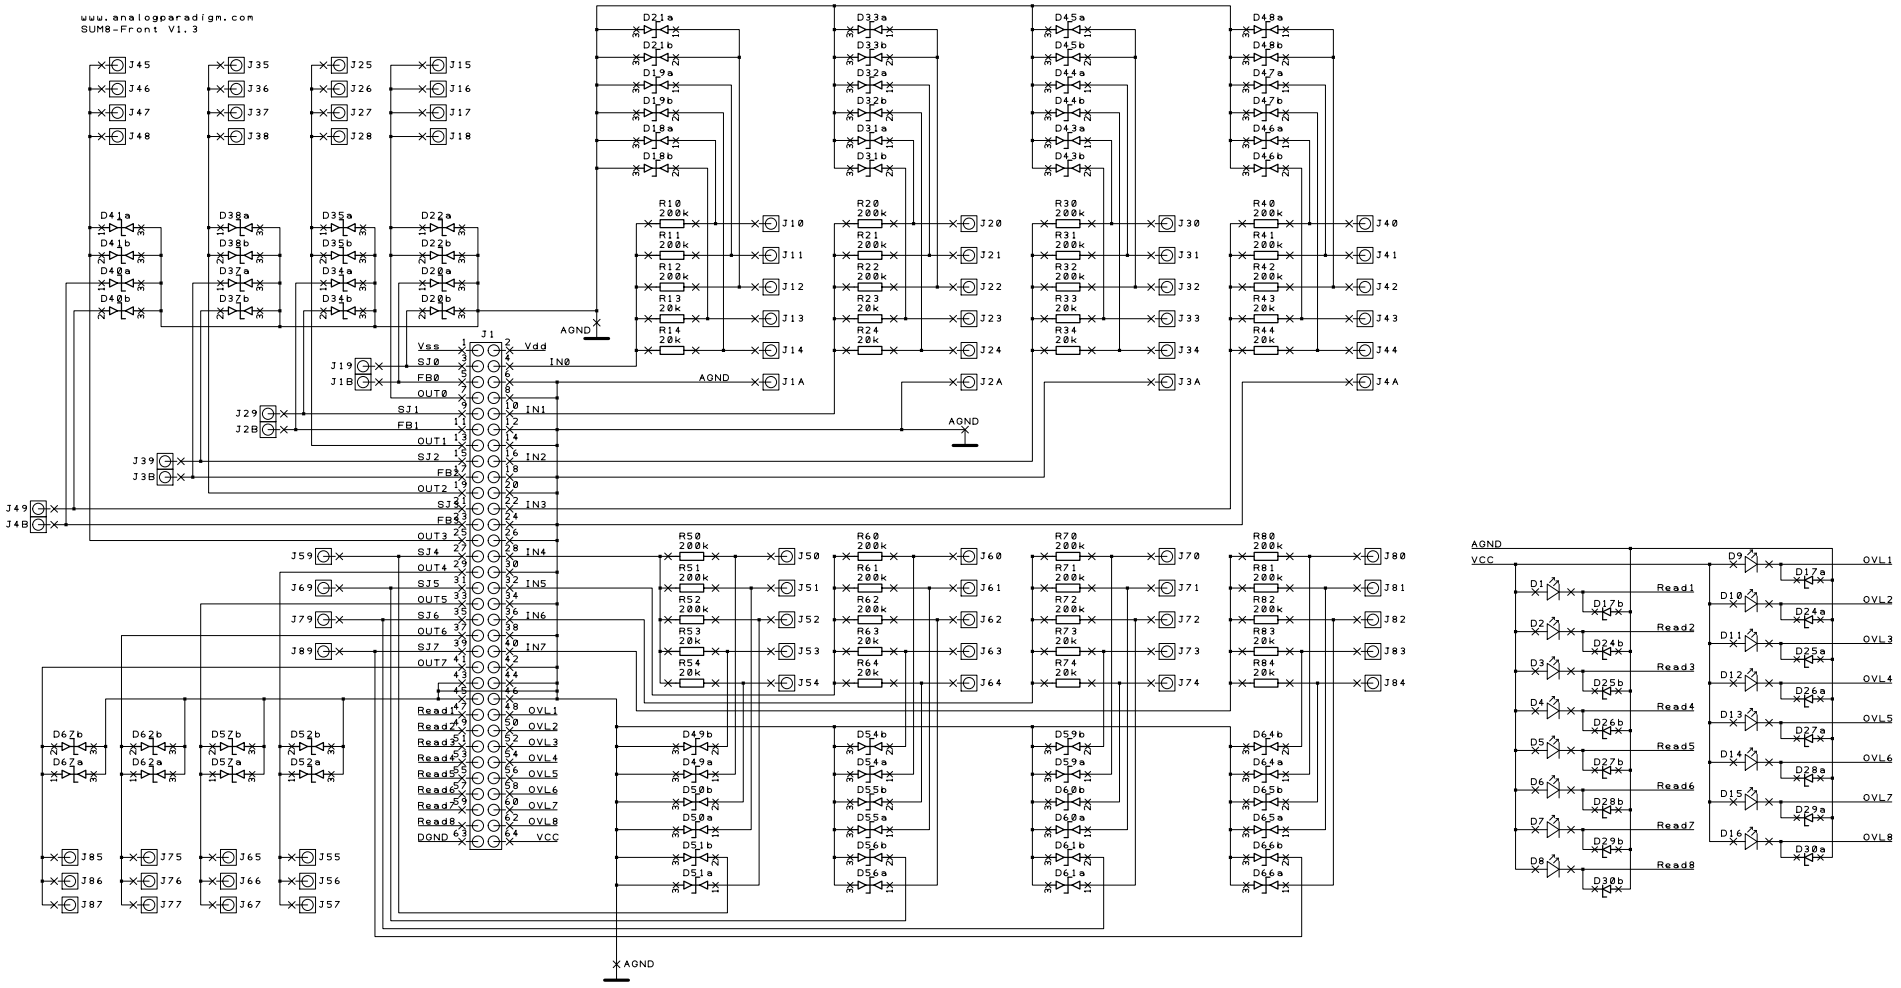
[picture p27: page 1]
