anabrid/Model-1/hardware/XBAR/XBAR - Schematic1.pdf

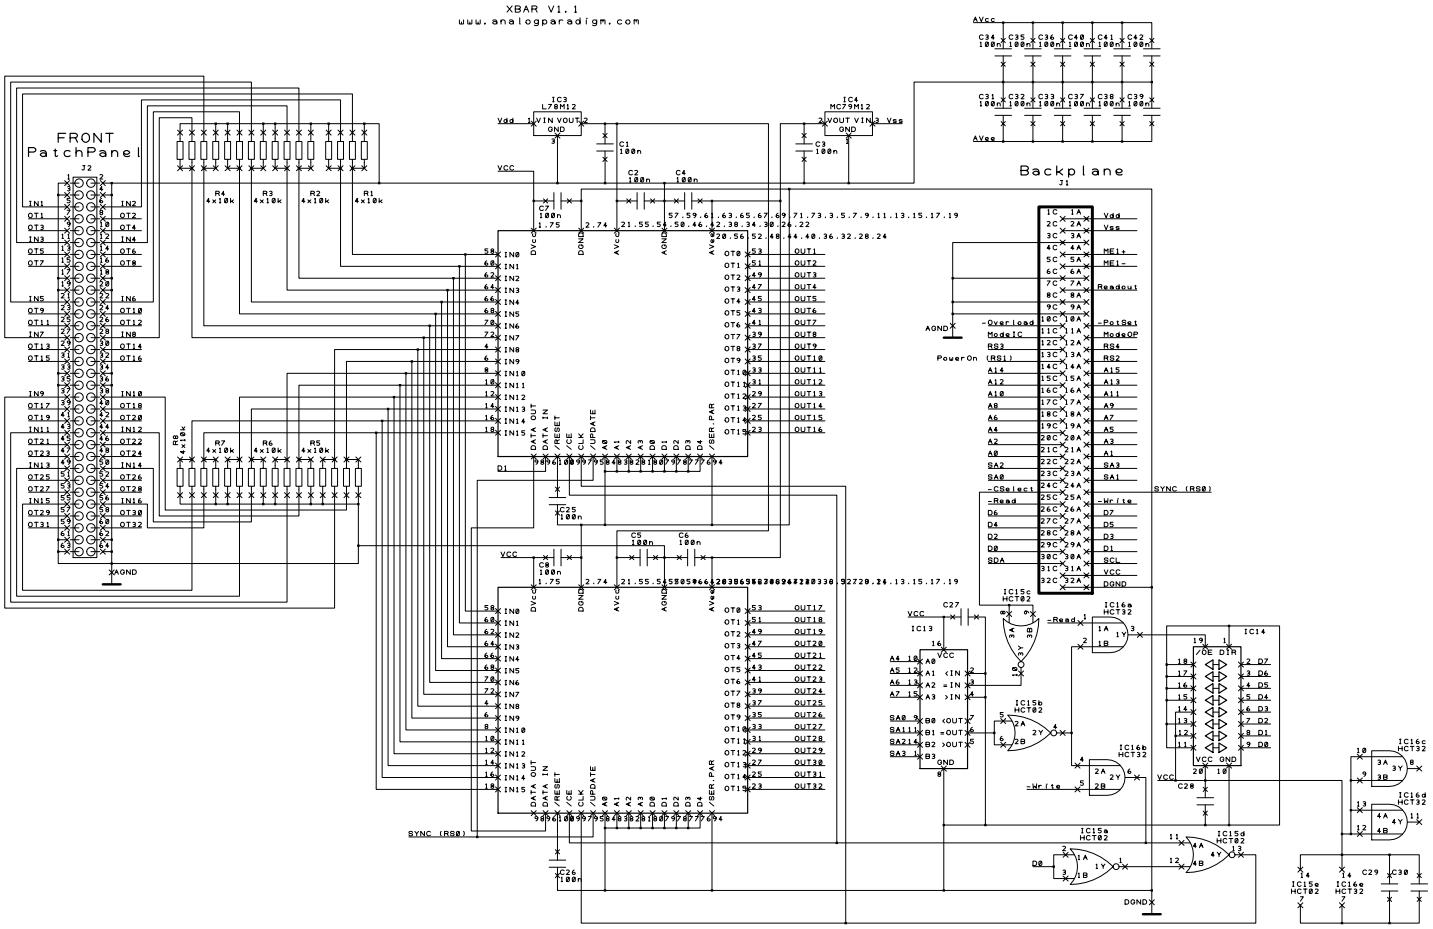
[picture p28: page 1]
