anabrid/Model-1/hardware/XBAR/XBAR - Schematic2.pdf

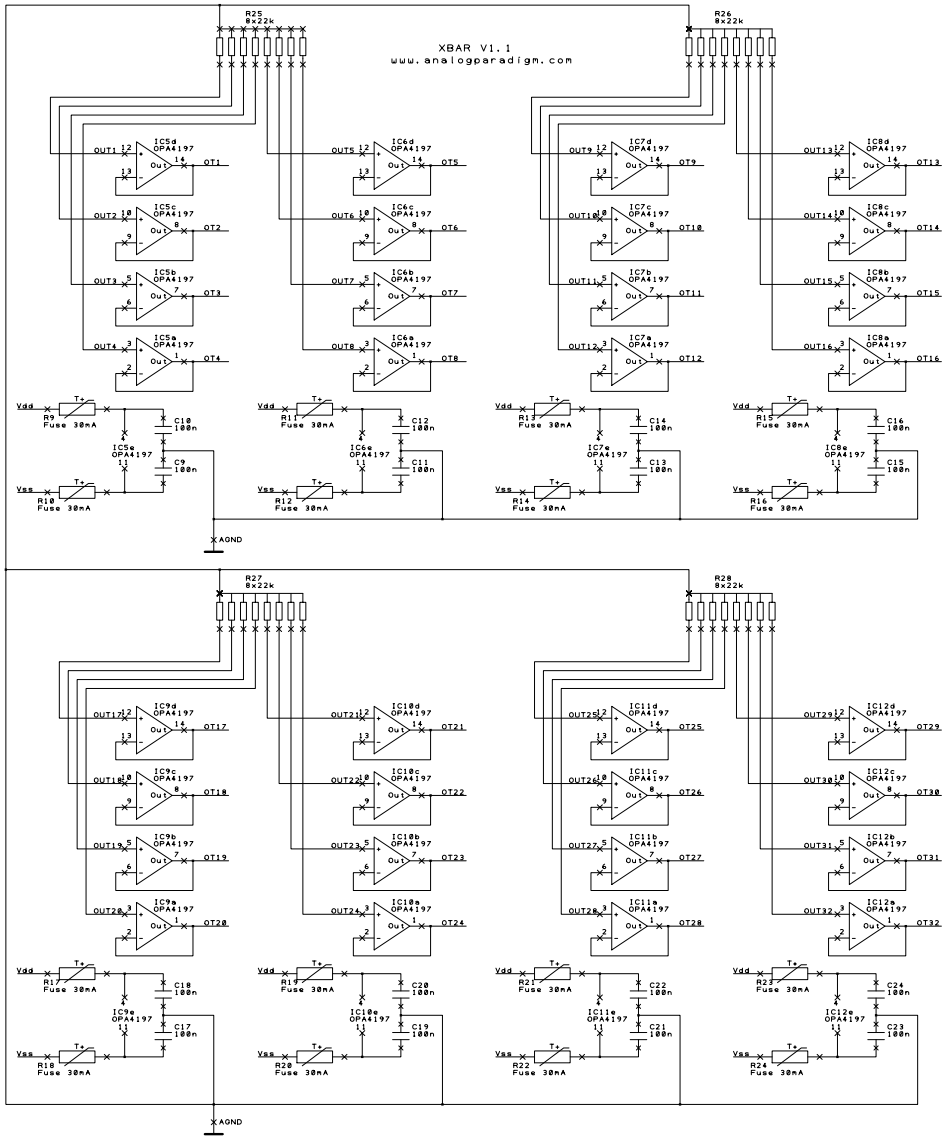
[picture p29: page 1]
