anabrid/Model-1/hardware/XBAR/XBAR-FRONT - Schematic.pdf

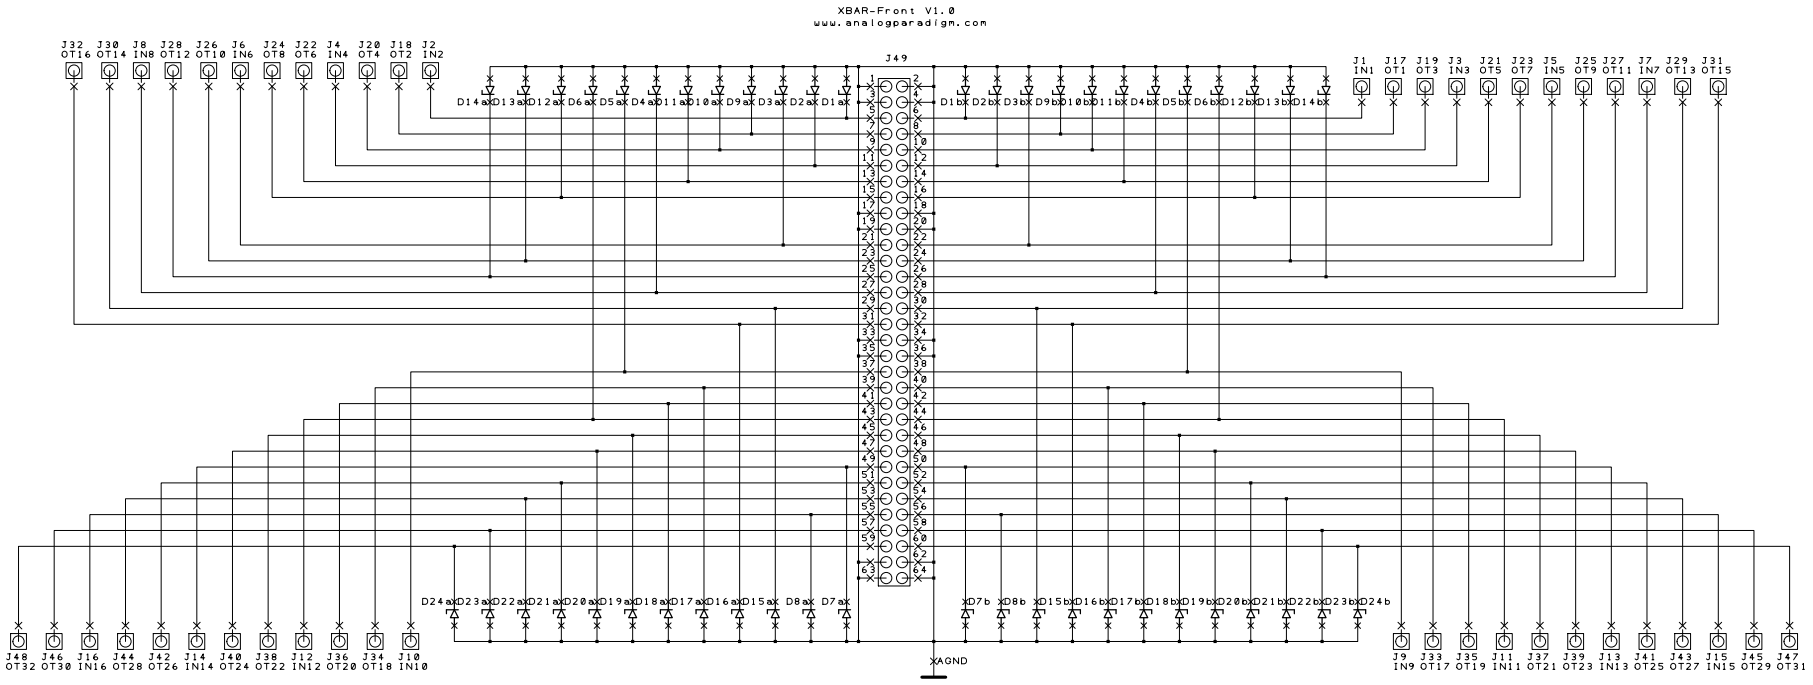
[picture p30: page 1]
