anabrid/Model-1/software/examples/mathieu/results/a_0.pdf

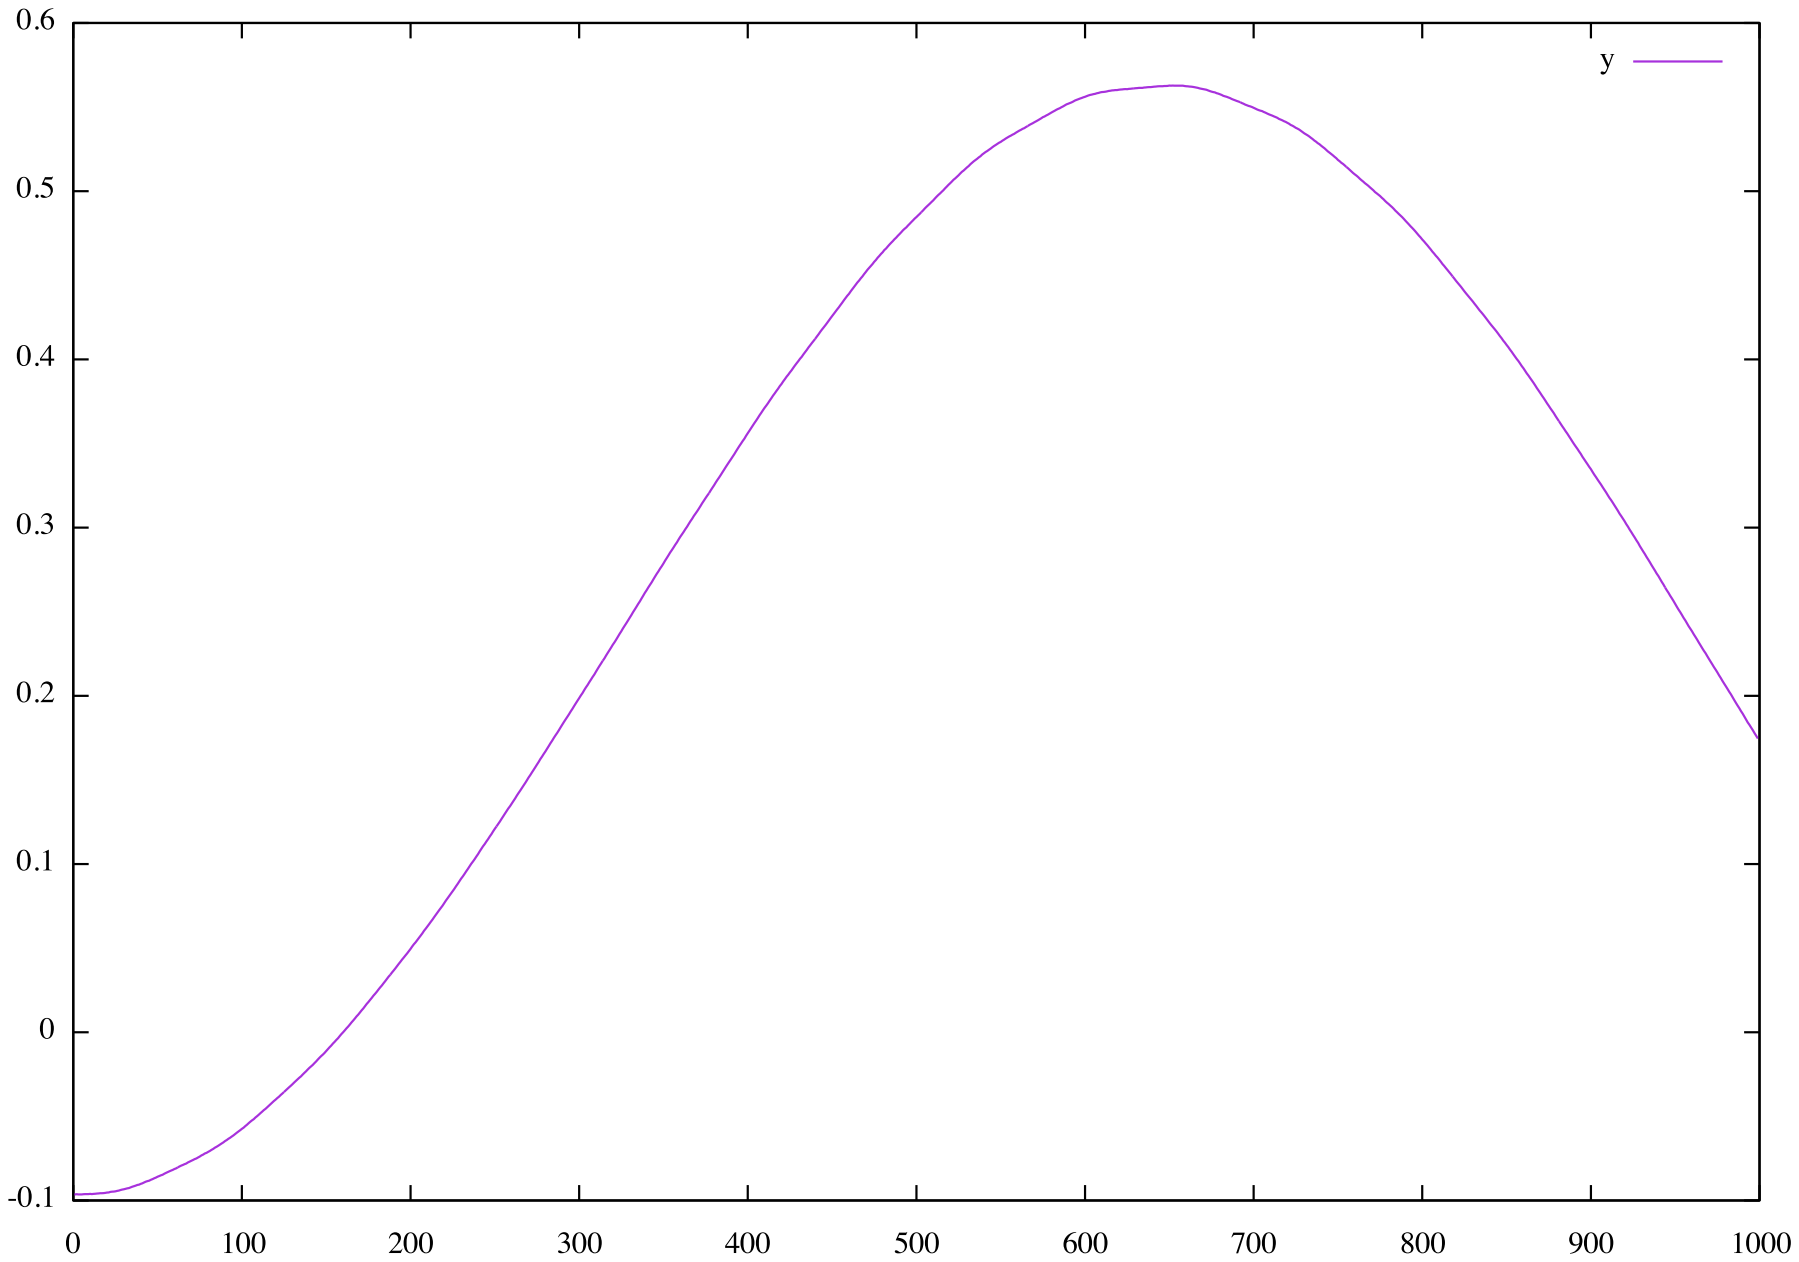
[picture p31: page 1]
