anabrid/Model-1/software/examples/mathieu/results/a_1.pdf

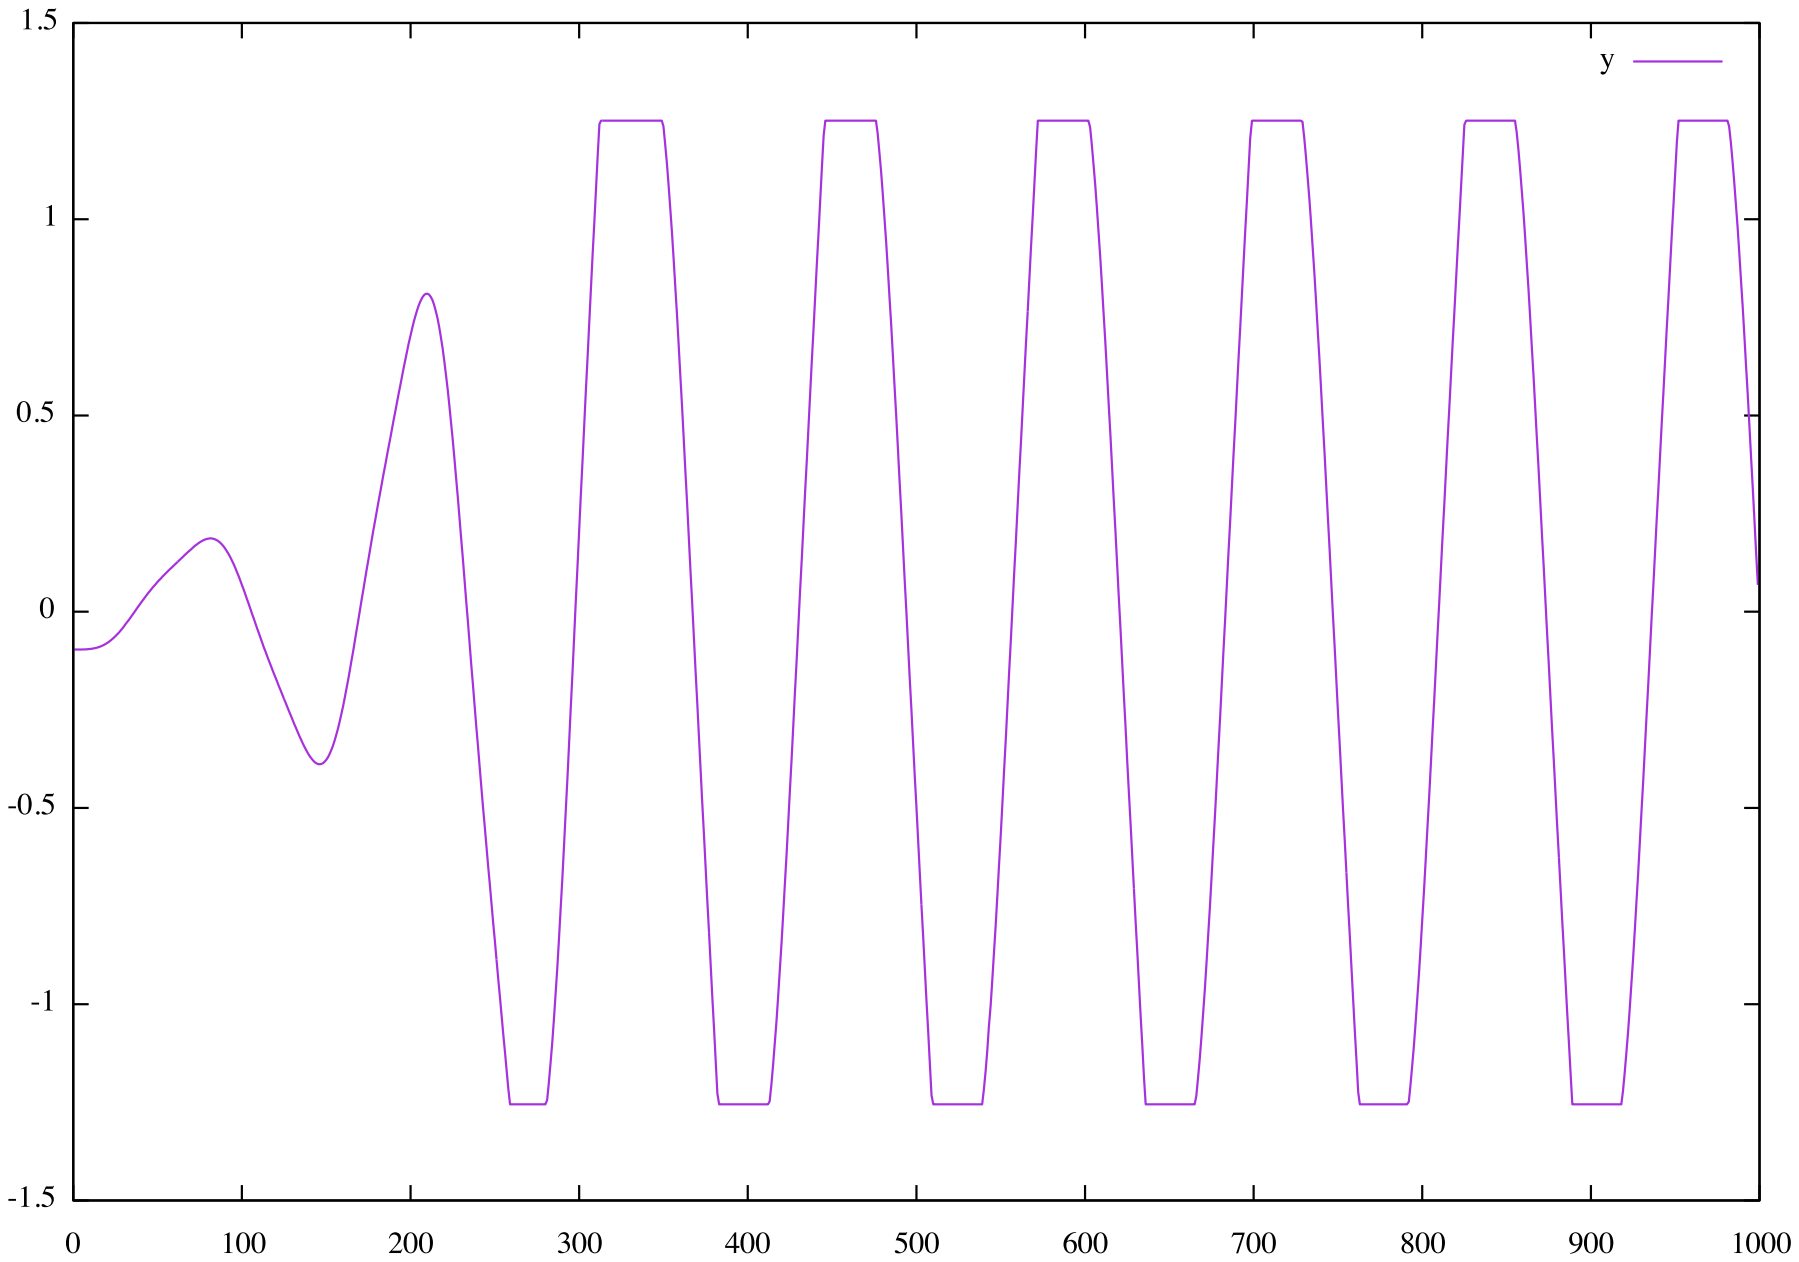
[picture p32: page 1]
