anabrid/Model-1/software/examples/mathieu/results/a_10.pdf

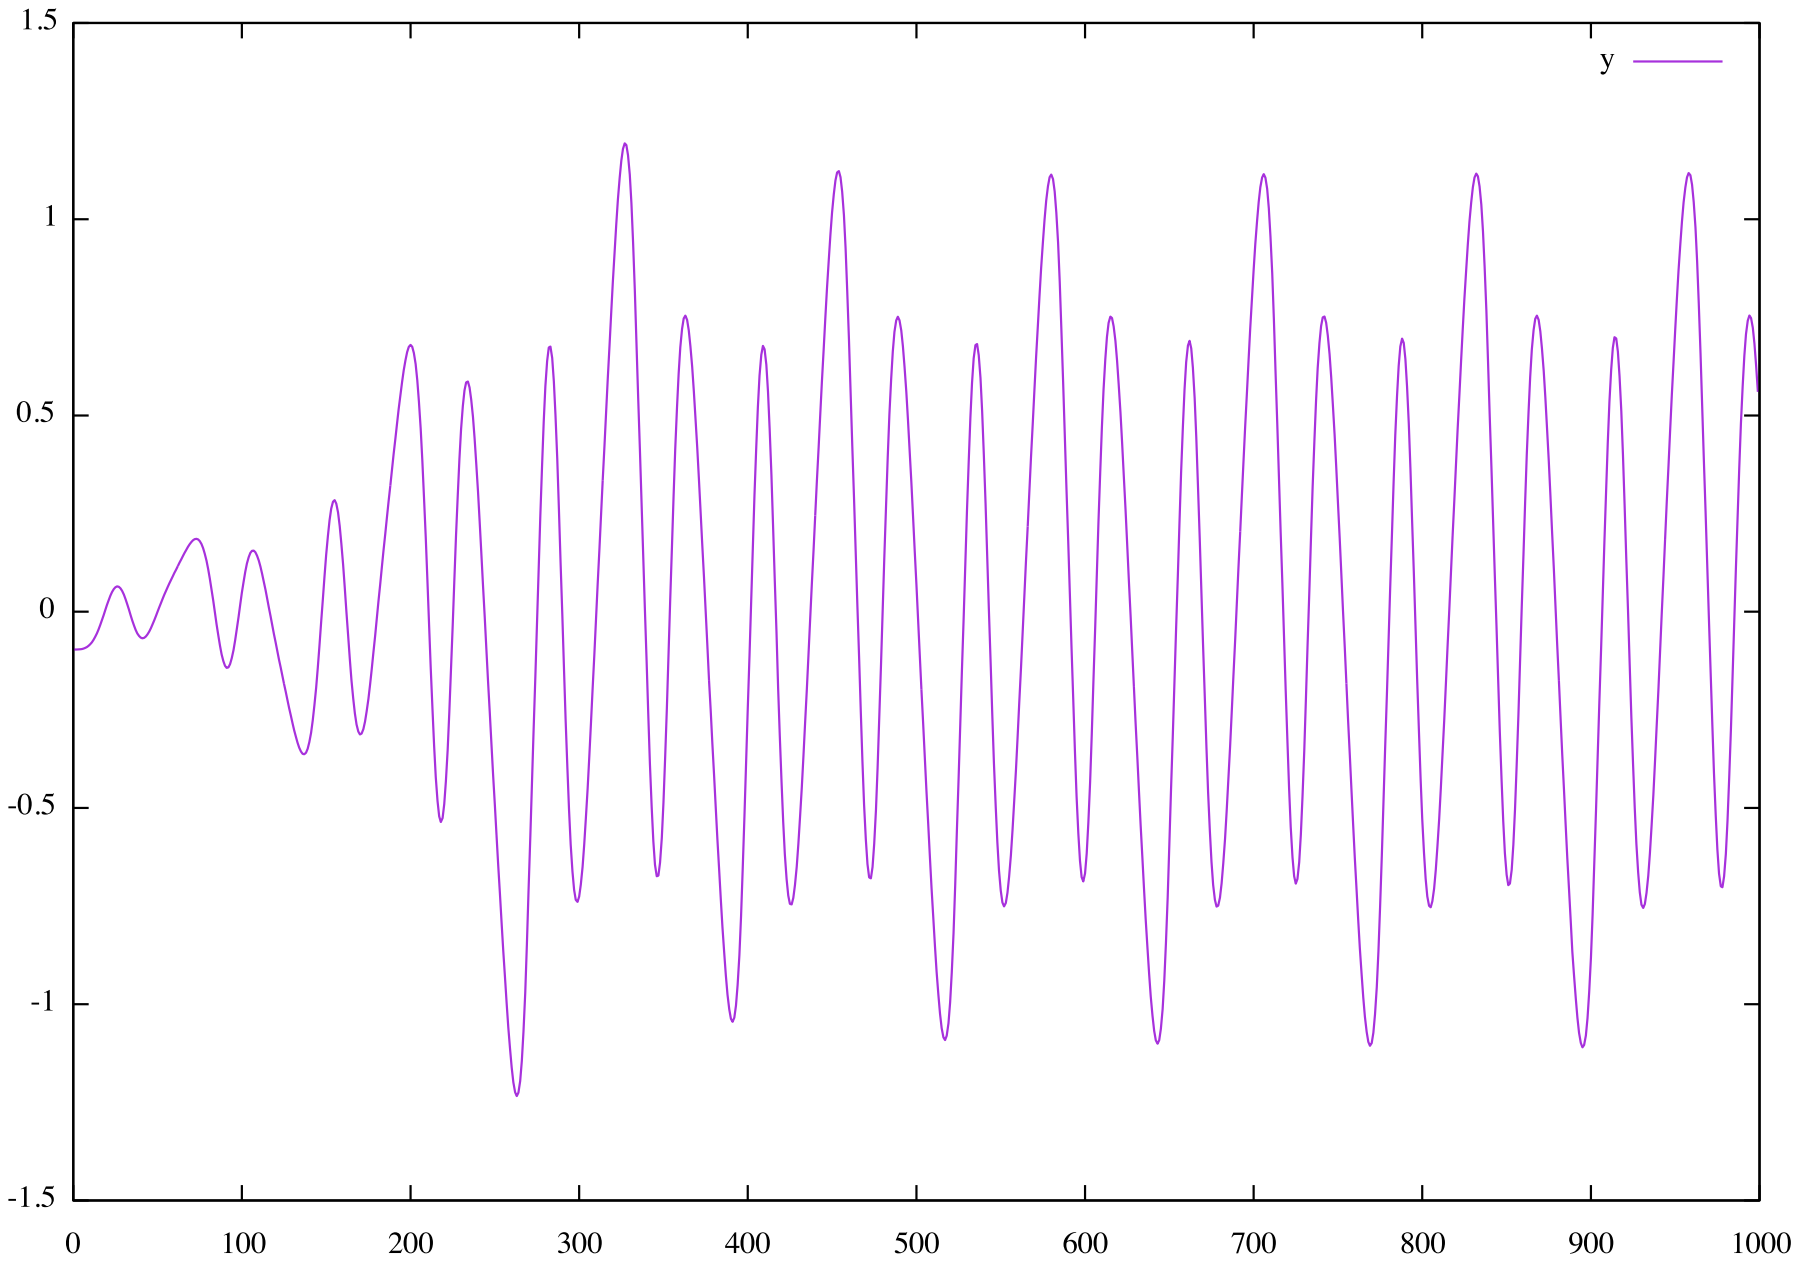
[picture p33: page 1]
