anabrid/Model-1/software/examples/mathieu/results/a_2.pdf

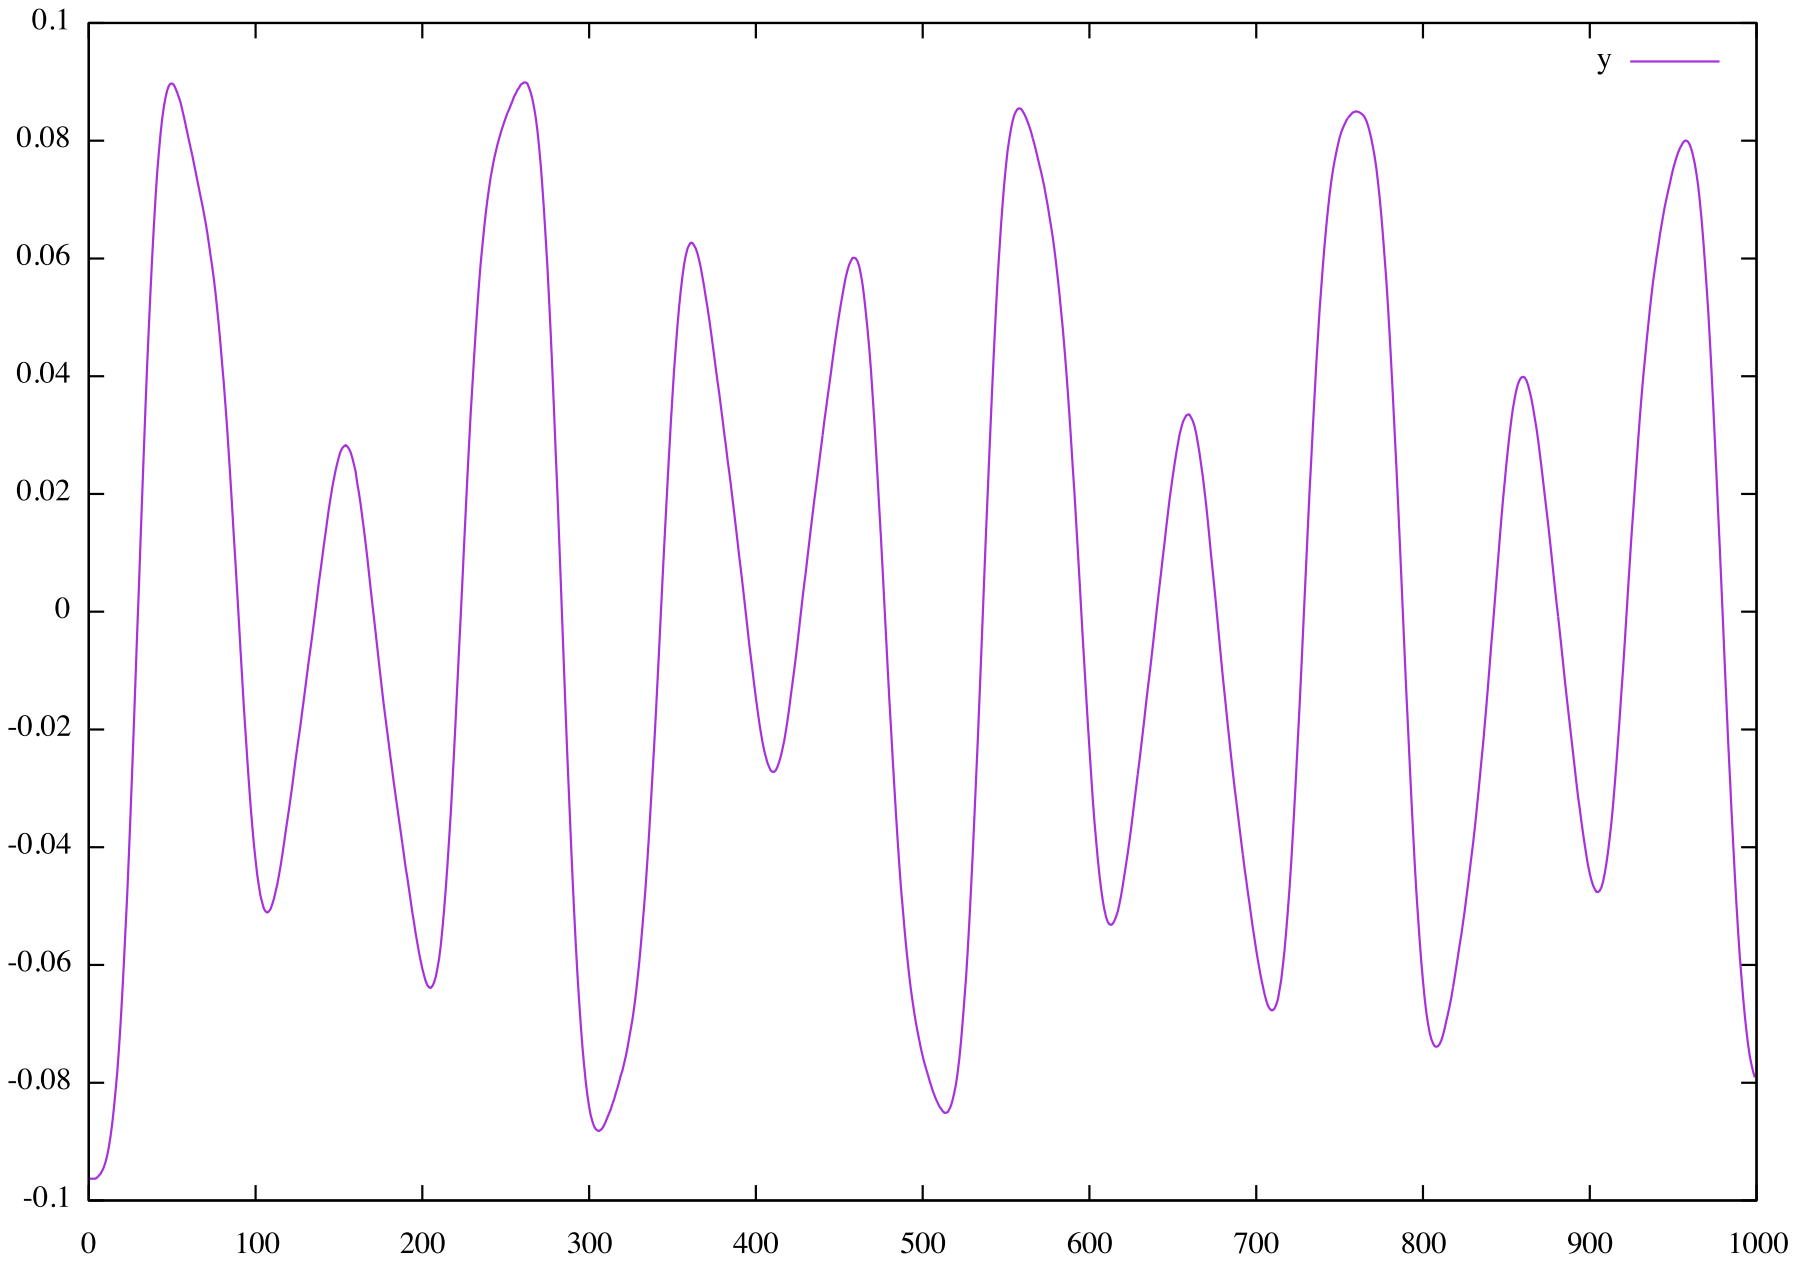
[picture p34: page 1]
