anabrid/Model-1/software/examples/mathieu/results/a_3.pdf

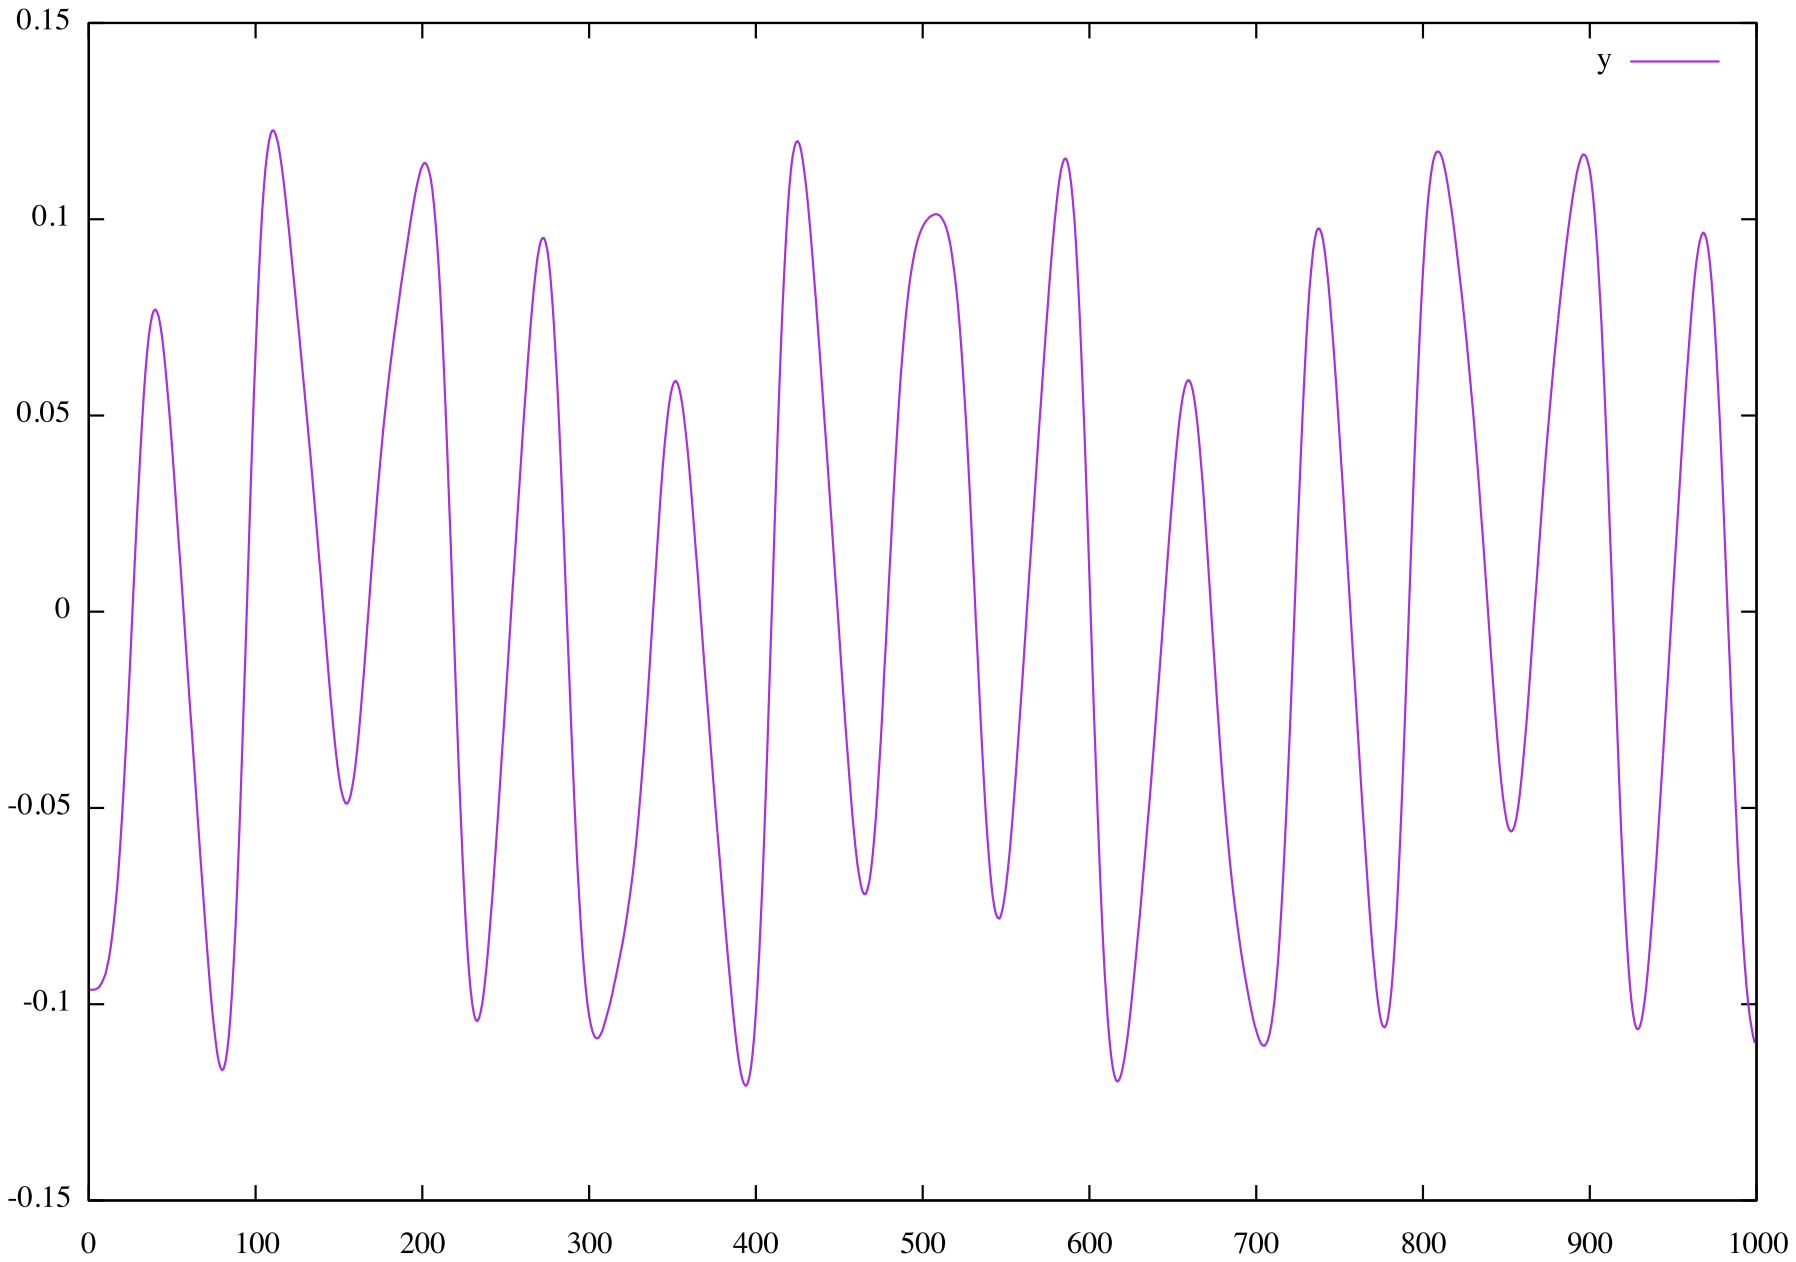
[picture p35: page 1]
