anabrid/Model-1/software/examples/mathieu/results/a_4.pdf

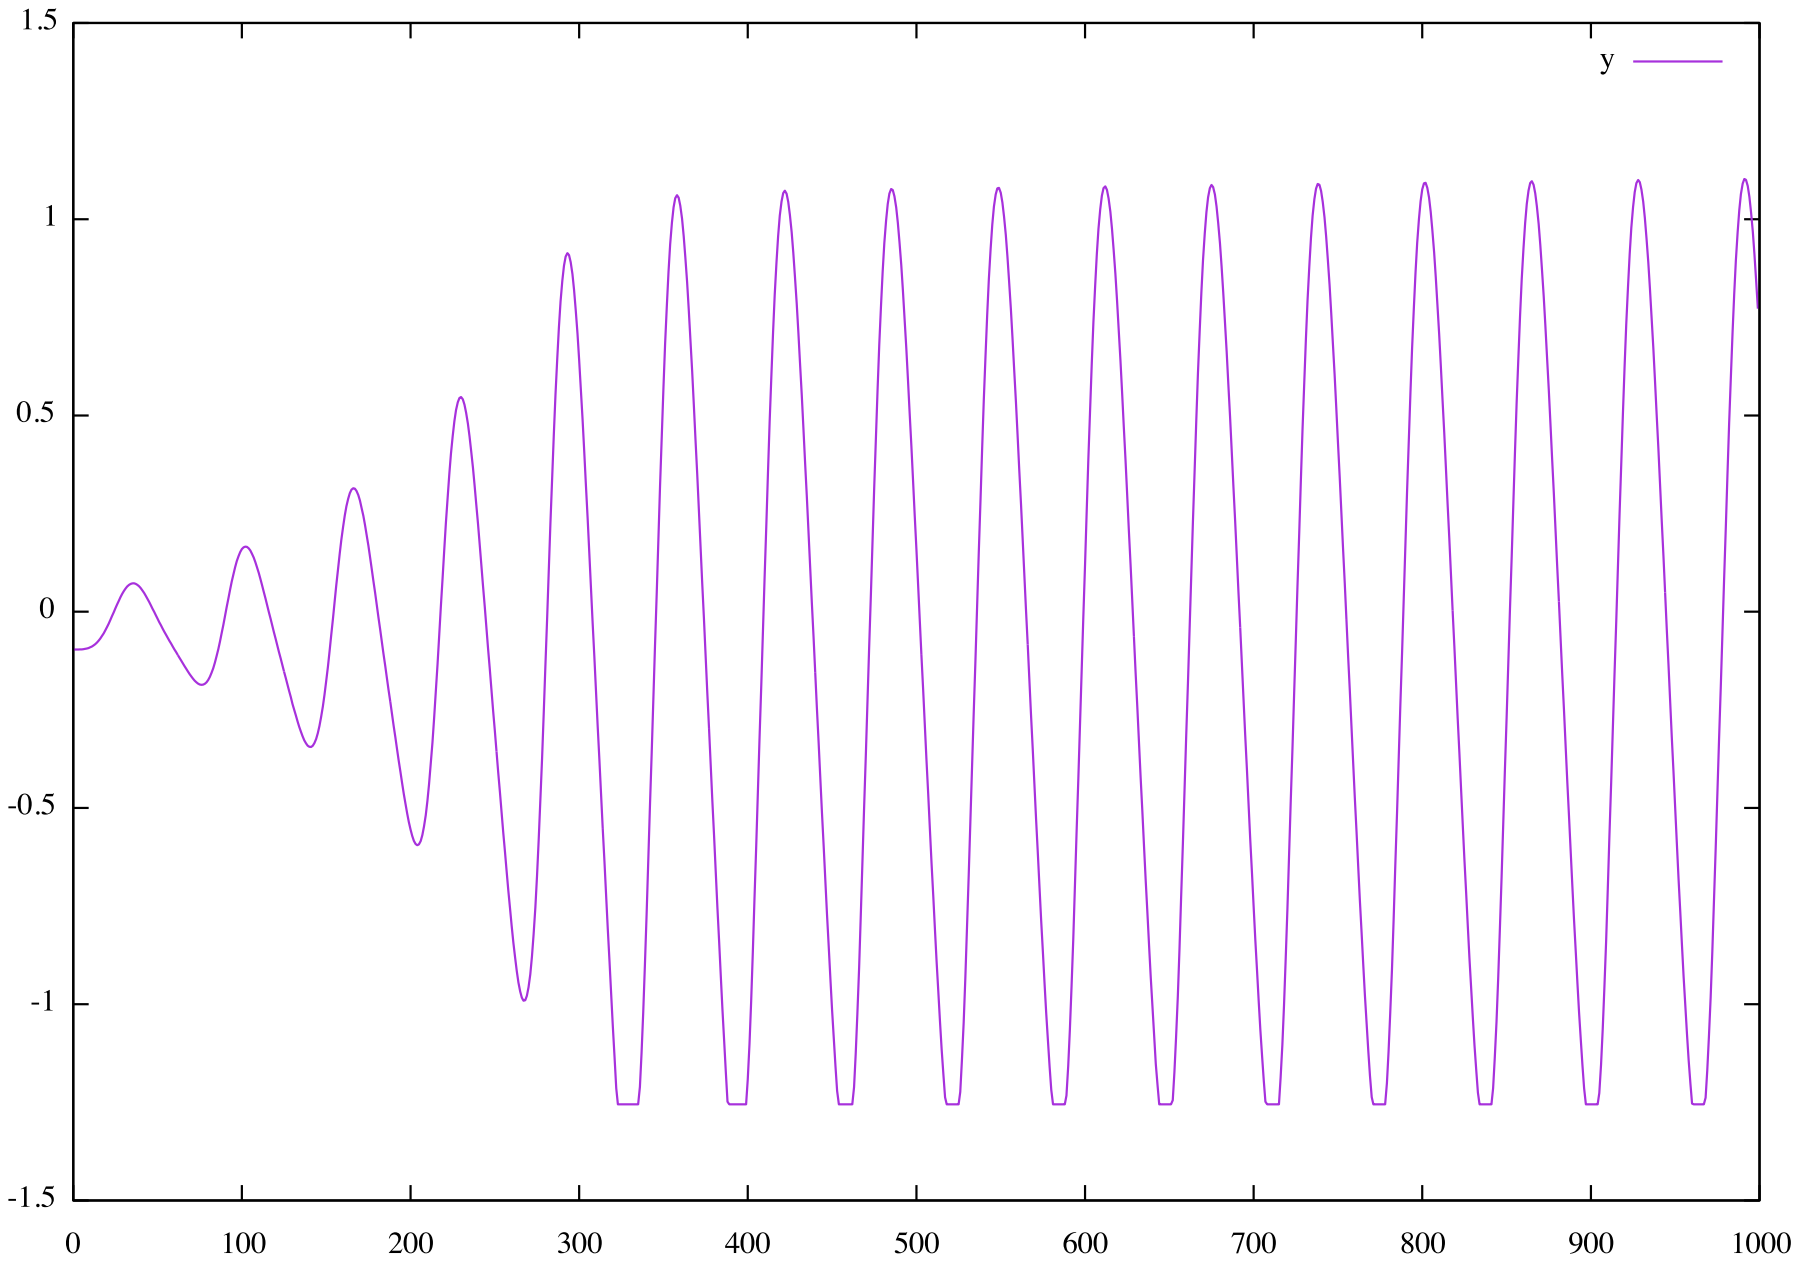
[picture p36: page 1]
