anabrid/Model-1/software/examples/mathieu/results/a_5.pdf

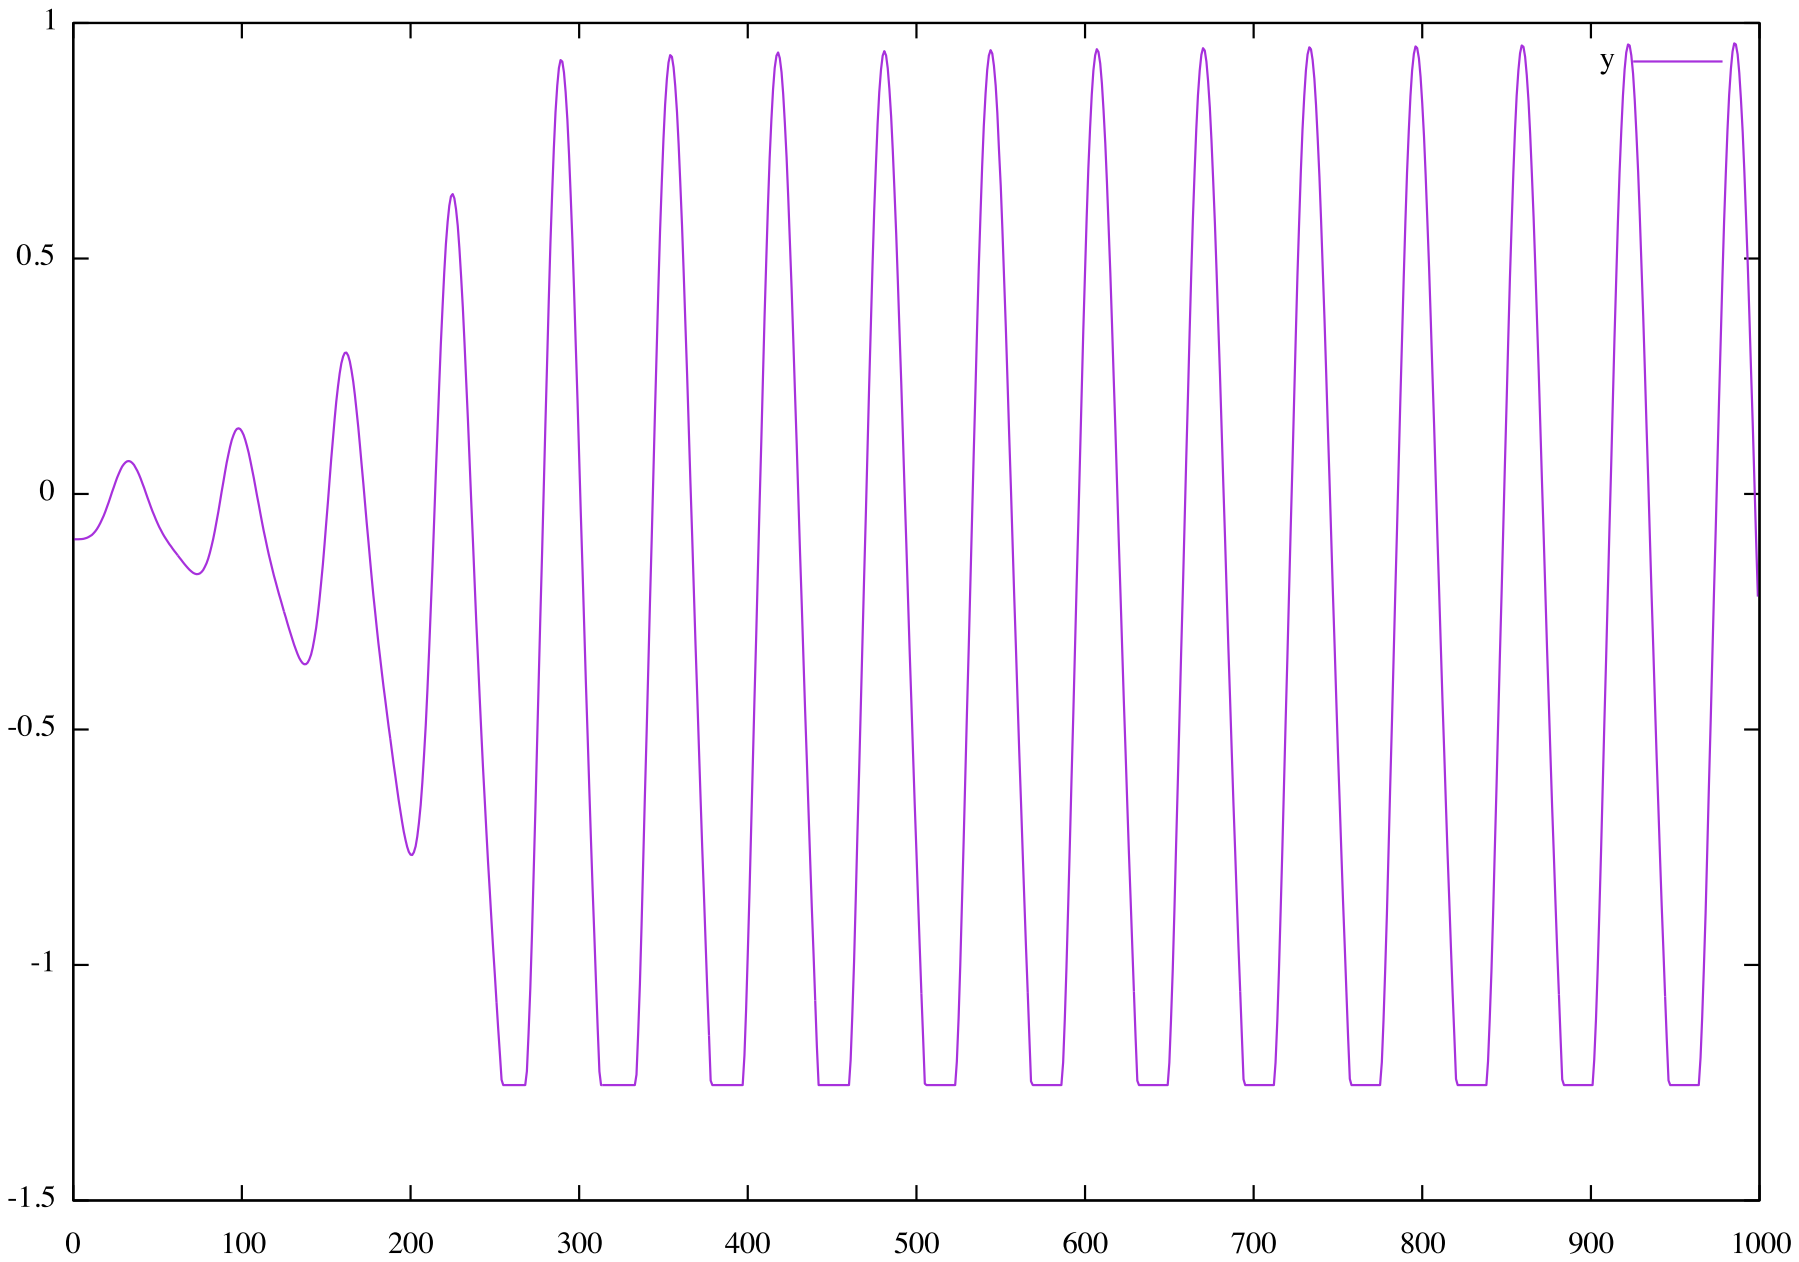
[picture p37: page 1]
