anabrid/Model-1/software/examples/mathieu/results/a_6.pdf

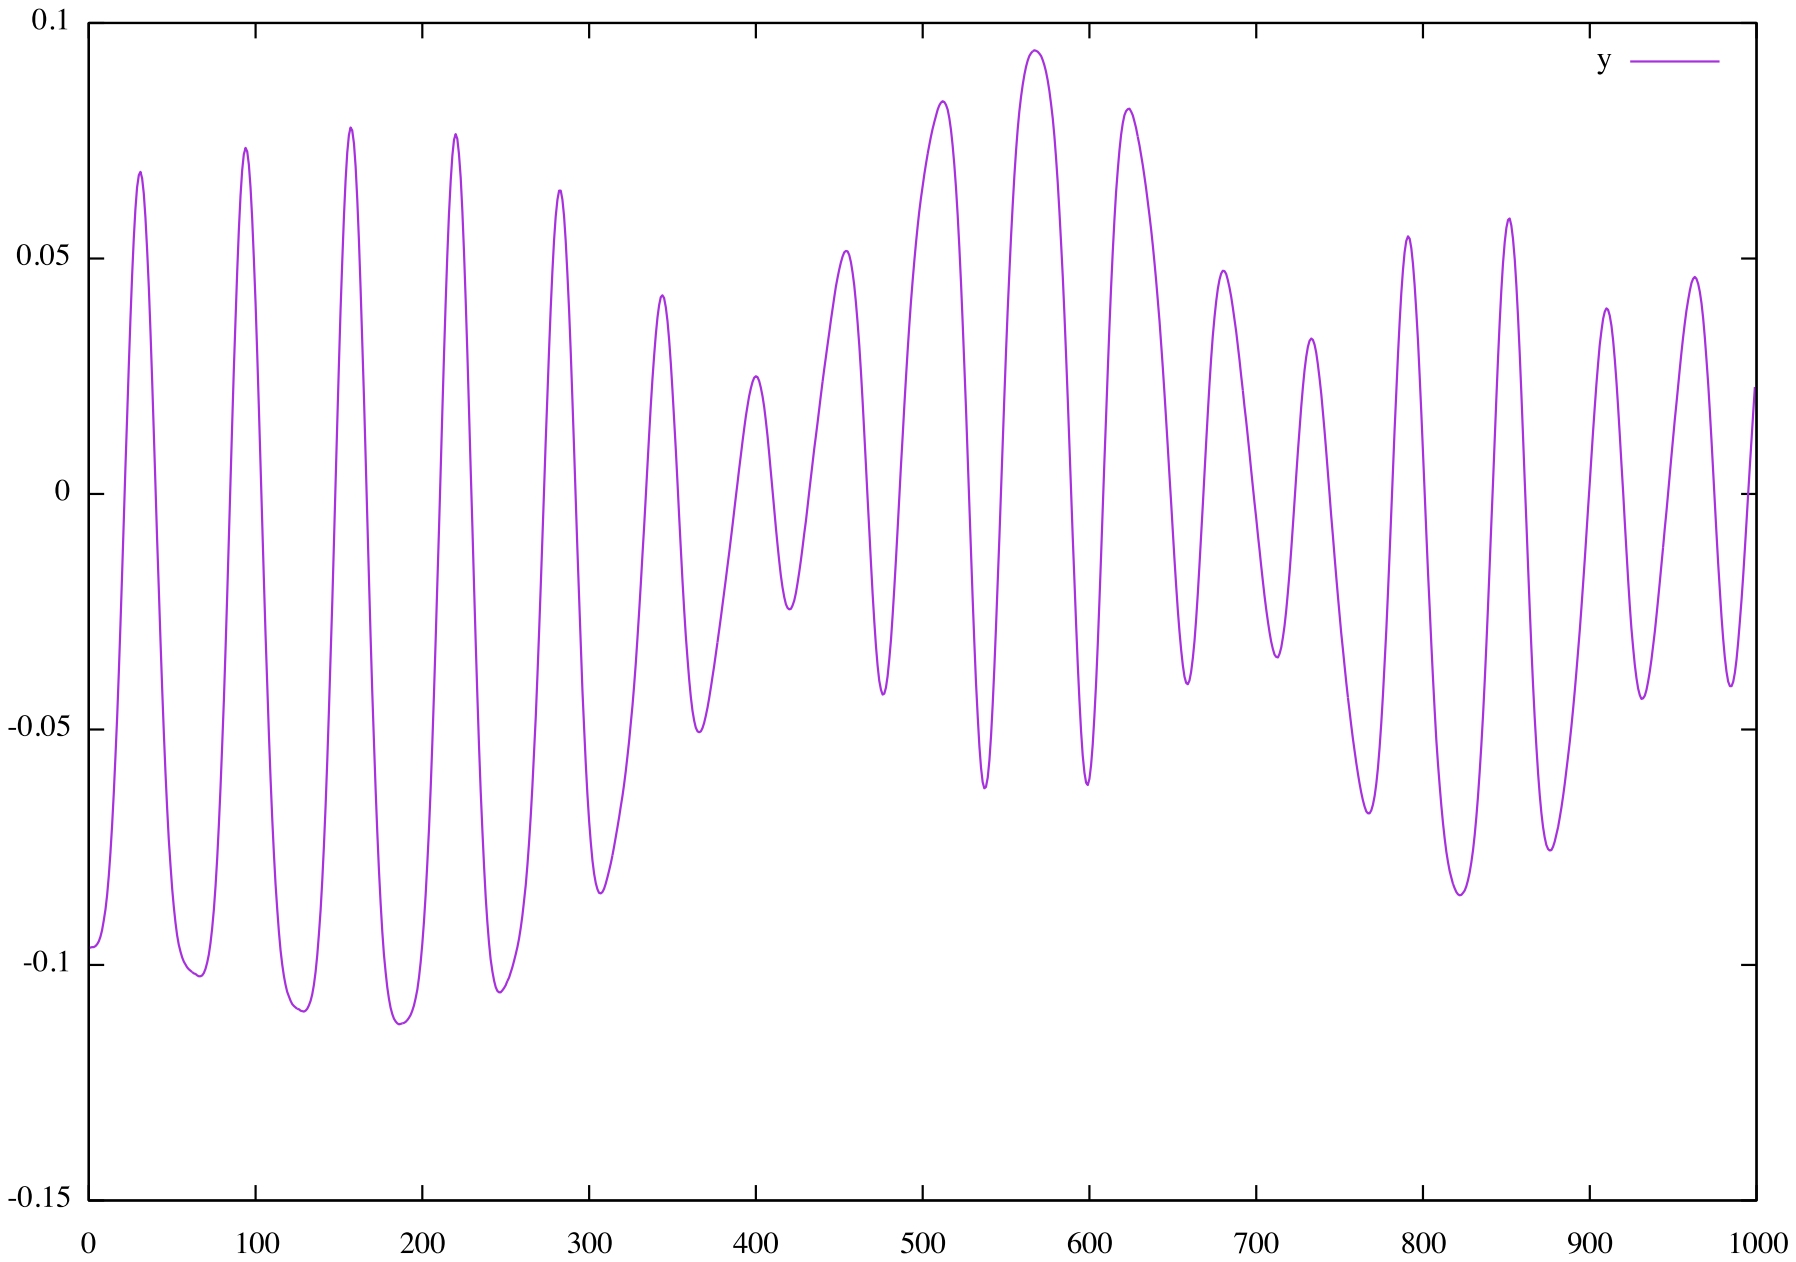
[picture p38: page 1]
