anabrid/Model-1/software/examples/mathieu/results/a_7.pdf

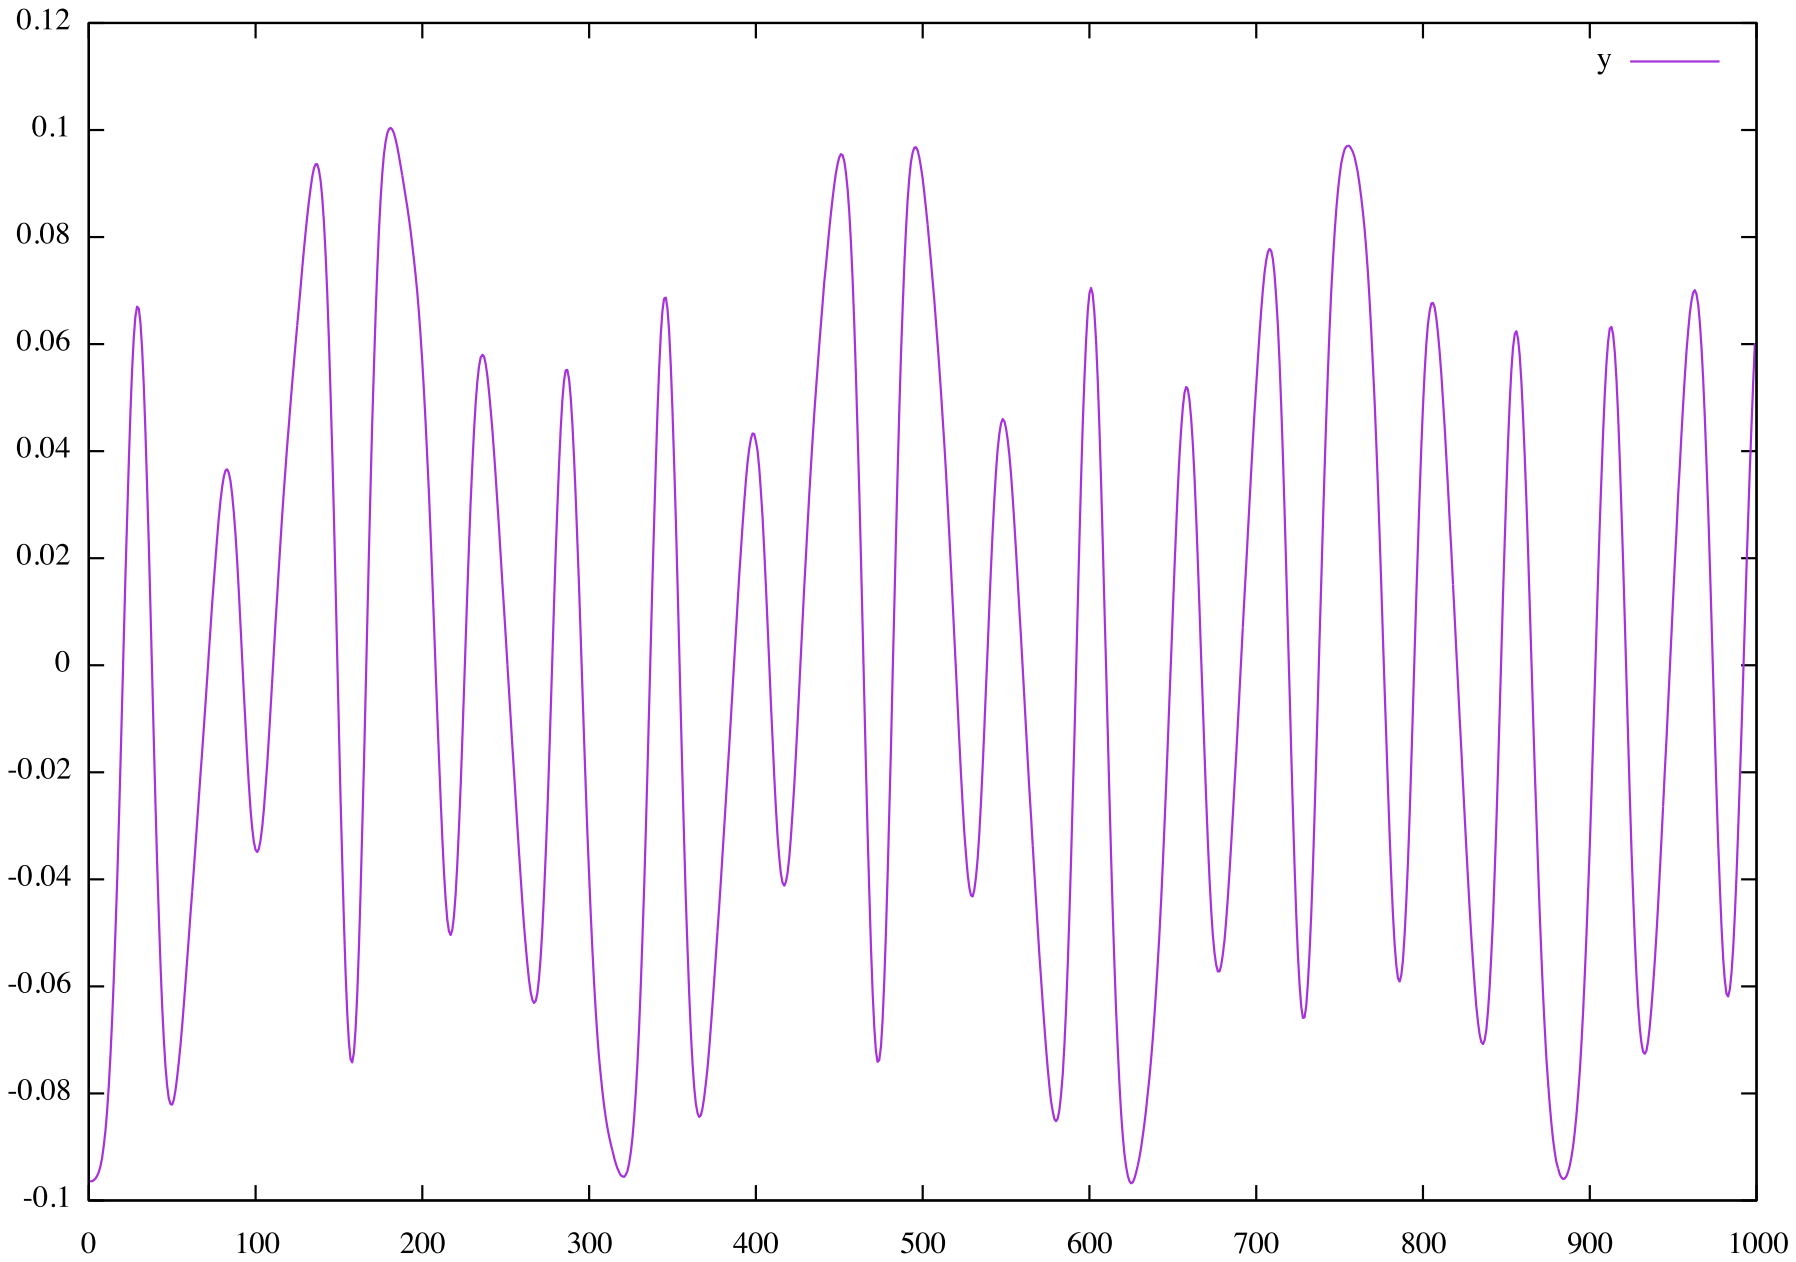
[picture p39: page 1]
