anabrid/Model-1/software/examples/mathieu/results/a_8.pdf

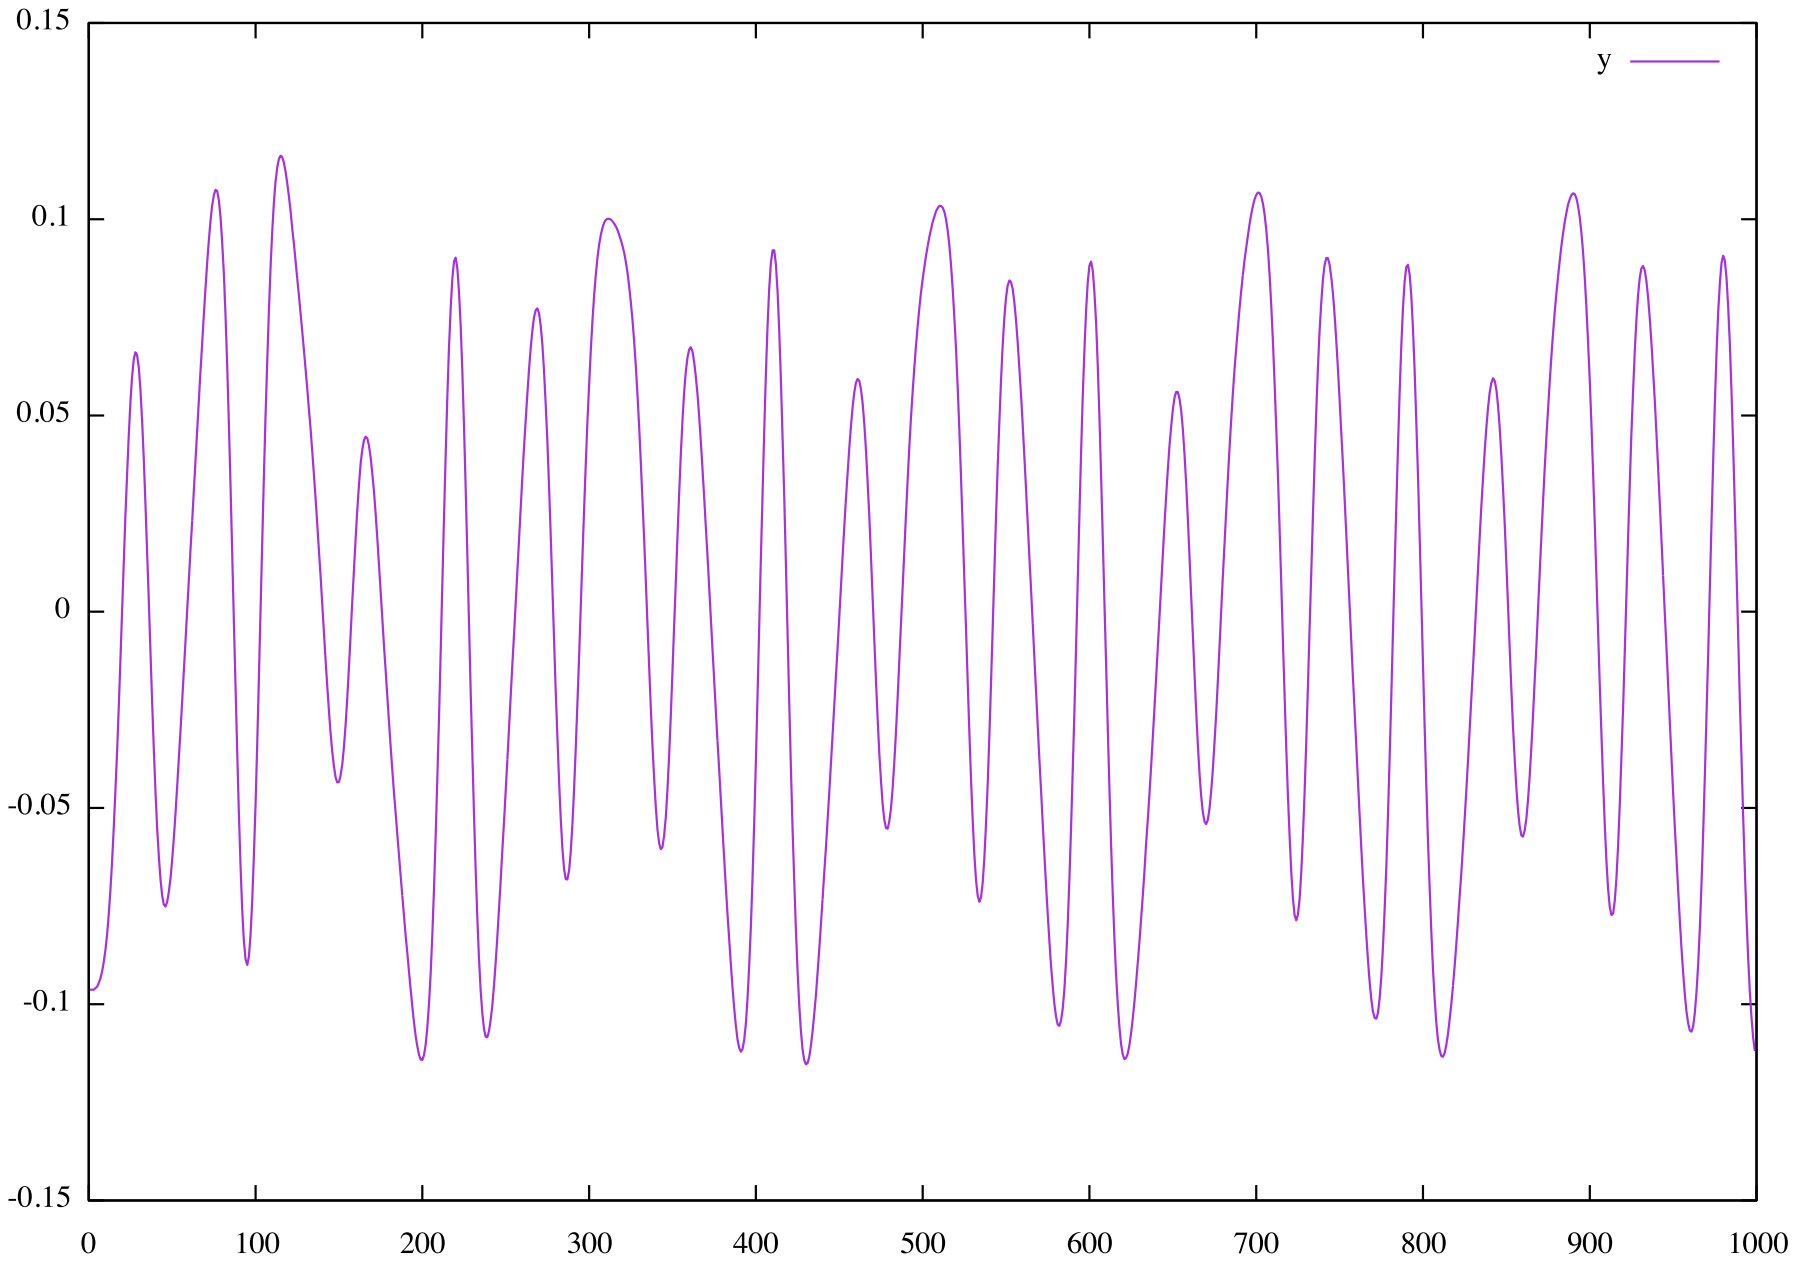
[picture p40: page 1]
