anabrid/Model-1/software/examples/mathieu/results/a_9.pdf

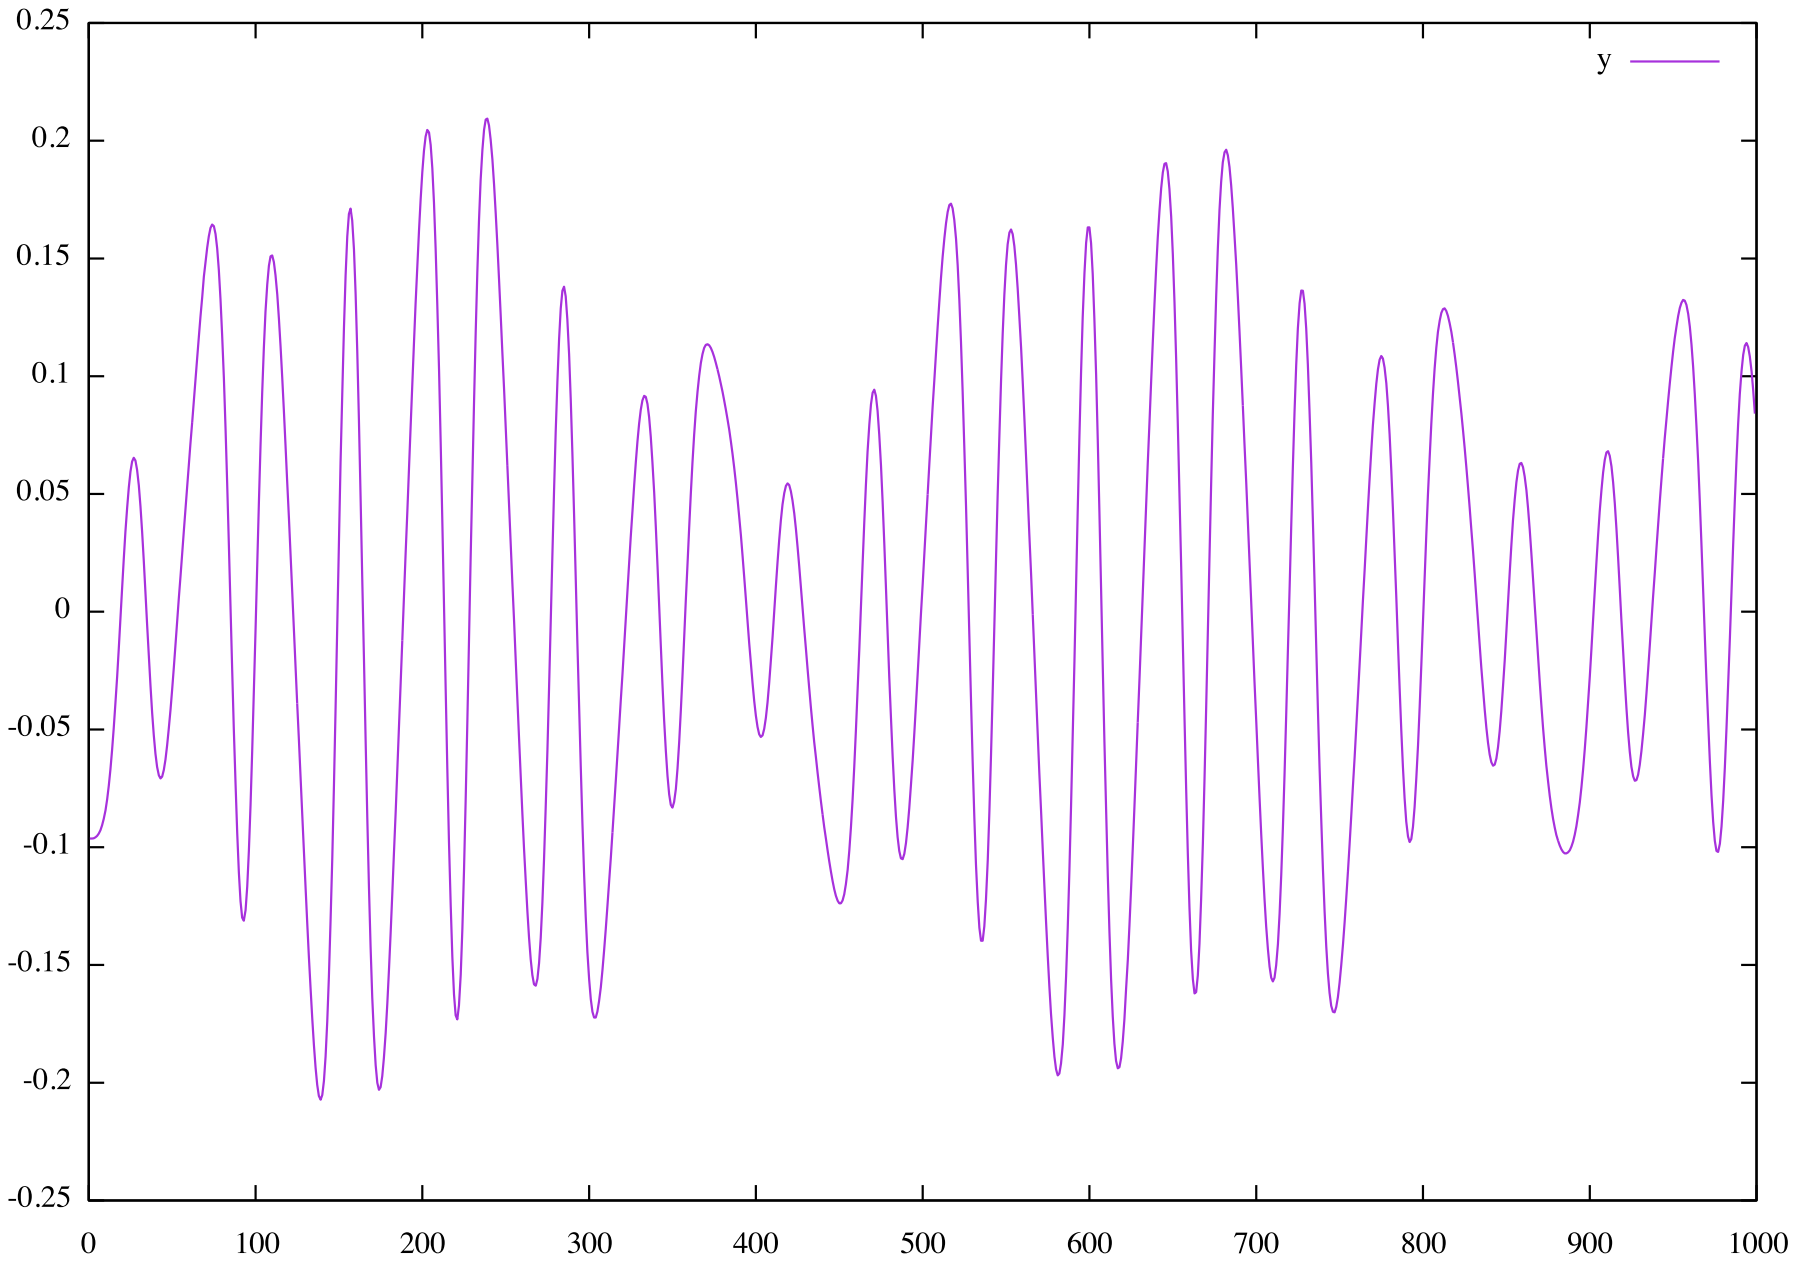
[picture p41: page 1]
