anabrid/Model-1/(commit log)

2020-12-09 Some minor bug fixes and added comments.
    [HyConAVR.ino]
2020-12-09 Fixed a timing issue in the read_adc() routine.
    [HyConAVR.ino]
2020-12-13 firmware directory no longer required.
    [HyConAVR.ino]
2020-12-15 F/E with A (overload halt enabled) missed every second OP-phase when an overload occurred which was due to calling halt() instead of stop_single_run() in the case of an overload which left a central 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
    [HyConAVR.ino]
2023-01-20 Added Model-1 schematics
2023-03-08 Reformatted; added note about unused CMP4 switch inputs which should be patched to ground.
